dsb92/smartpram/README.txt

SmartPram - Den intelligente barnevogn
- 3. semesterprojekt

Projektbeskrivelse: Systemet eksisterer for, at kunne få en baby til at falde i s
øvn/berolige den. Brugeren har
mulighed for at definere, hvordan systemet skal fungere via sit Devkit8000. Der kan indstilles
vuggetid, urotid og lydstyrke, som systemets automatiske funktioner reagerer på. Yderligere
kan brugeren indstille den temperatur-værdi som han/hun 
ønsker barnevognen max/min må
være. Brugeren kan tænde og slukke for den automatiske funktion eller selv kø
re en cyklus af
motorerne ved at trykke på de manuelle knapper.

Hvad jeg har arbejdet med: Linux programmering, Backend driver til Devkit8000, håndtering af beskeder og flertrådet system.
