dsb92/smartpram/Hardware/Komponentliste.pdf

## PSoC kredsløb

Komponentnavn | Type | Størelse
X101 | Sikring | 1,6 A
C101 | Kondensator | 10 µF
C102 | Kondensator | 100 nF
C103 | Kondensator | 100 nF
C104 | Kondensator | 100 nF
C105 | Kondensator | 1 µF
R101 | Modstand | 2,2 kΩ
R102 | Modstand | 100 kΩ
R103 | Modstand | 10 kΩ
R104 | Modstand | 10 kΩ
R105 | Modstand | 10 kΩ
R106 | Modstand | 10 kΩ
R107 | Modstand | 10 kΩ
R108 | Modstand | 10 kΩ
R109 | Modstand | 10 Ω
R110 | Modstand | 100 kΩ
R111 | Modstand | 100 kΩ
R112 | Modstand | 1 MΩ
R113 | Modstand | 100 kΩ
NTC_100K | Modstand | Variabel mellem
LM_7805 | Spændingsregulator | Regulerer fra 12V til 5V
Q101 | MOSFET Transistor | IRLZ44N
Q102 | MOSFET Transistor | IRLZ44N
U102 | 2233f024s DC motor | 308:1
U103 | IC34 DC motor | 729:1
U105 | PSoC 3 Microcontrolller
U104 | ZigBee | MRF24J40MA
Mikrofon | MCE-100 | 0,1-4,7 µF
U107 | AD620 Instrumenteringsforstærker

## DevKit Kredsløb

Komponentnavn | Type | Størelse
U201 | DevKit8000 Port J5
U202 | DevKit8000 Port J9
U203 | ZigBee | MRF24J40MA
R201 | Modstand | 10 kΩ
R202 | Modstand | 10 kΩ
R203 | Modstand | 10 kΩ
R204 | Modstand | 10 kΩ
C201 | Kondensator | 100 nF

# Komponentliste
