dsb92/smartpram/Software/DevKit8000/Design/Klassediagram_Devkit.pdf

Class Application model

UIController

+ enum { ID_CRADLE_STOPPED, ID_MOBILE_STOPPED, ID_SETTINGS_CFM, ID_MEASUREMENTS }
- MAX_QUEUE_SIZE: static const int
- manualMq_: osapi::MsgQueue*
- settingsCtrlMq_: osapi::MsgQueue*
- automaticMq_: osapi::MsgQueue*
- mq_: osapi::MsgQueue
- running_: bool
+ cradleOnManUIbutton_: bool
+ mobileOnManUIbutton_: bool
- minTemp_: bool
- maxTemp_: bool
- soundHigh_ : bool
+ minTemperatur_: signed char + maxTemperatur_: signed char + maxSound_: signed char
+ temperatur_ : signed char
+ sound_: signed char
+ cradleTime_: unsigned int + mobileTime_: unsigned int

+ setMqs(manualMq: osapi::MsgQueue*, osapi::MsgQueue automaticMq_, settingsCtrlMq: osapi::MsgQueue): void
+ startCradle() : void
+ stopCradle() : void
+ startMobile() : void
+ stopMobile() : void
+ startAutomatic() : void
+ stopAutomatic() : void
+ getCurrentSettings() : void
+ setSaveSettings(_cradleTime: unsigned int, _cradleSpeed: unsigned char, _mobileTime: unsigned int, _mobileSpeed: unsigned char, _minTemperatur: signed char, _maxTemperatur: signed char, _maxSound: signed char )
+ setDefaultSettings(): void
+ getMsgQueue(): osapi::MsgQueue* : void
- void handleMsg(msg :osapi::Message*, id: unsigned long) : void # run(): void

osapi::Message

osapi:Thread

«utility»
main
- objUIController: UIController
- objManuelController: ManuelController
- objAutomaticController: AutomaticController
- objMeasurementsController: MeasurementsController
- objSettings: Settings
- objCradle: Cradle
- objMobile: Mobile
- objZigBeeIF_out: ZigBeeIF_out
- objZigBeeIF_in: ZigBeeIF_in
- thrUIController: osapi::Thread
- thrManuelController: osapi::Thread
- thrAutomaticController: osapi::Thread
- thrMeasurementsController: osapi::Thread
- thrCradle: osapi::Thread
- thrMobile: osapi::Thread
- thrZigBeeIF_in: osapi::Thread
- thrZigBeeIF_out: osapi::Thread

1

8

Settings

- cradleTime_: unsigned int
- mobileTime_: unsigned int
- cradleSpeed_: unsigned char
- mobileSpeed_: unsigned char
- minTemperature_: signed char
- maxTemperature_: signed char
- maxSound_: signed char

+ setCradleTime(unsigned int) : void
+ setMobileTime(unsigned int) : void
+ setCradleSpeed(unsigned char) : void + setMobileSpeed(unsigned char) : void + setTempMax(signed char) : void
+ setTempMin(signed char) : void
+ setMaxSound(signed char) : void
+ getCradleTime() : unsigned int
+ getMobileTime() : unsigned int
+ getCradleSpeed() : unsigned char + getMobileSpeed() : unsigned char + getMaxTemperatur() : signed char + getMinTemperatur() : signed char + getMaxSound() : signed char

SettingsController

+ enum { ID_SAVE_SETTINGS, ID_SETTINGS_REQ, ID_DEFAULT_SETTINGS }
- MAX_QUEUE_SIZE: static const int
- UIMq_: osapi::MsgQueue*
- mq_: osapi::MsgQueue
- cradleMq_: osapi::MsgQueue
- mobileMq_: osapi::MsgQueue
- UIMq_: osapi::MsgQueue
- measurementsMq_: osapi::MsgQueue
- running_: bool
- settingsPtr_: Settings*

+ getMsgQueue(): osapi::MsgQueue*
- void handleMsg(msg :osapi::Message*, id: unsigned long): void
# run(): void

+ setMqs( osapi::MsgQueue* UIMq, osapi::MsgQueue* cradleMq, osapi::MsgQueue* mobileMq, osapi::MsgQueue* measurementsMq ): void
+ init() : void
+ saveSettings() : void
+ loadSettings() : void
+ loadDefaultSettings() : void + broadcastSettings() : void

MsgSettings

- cradleTime: unsigned int
- mobileTime: unsigned int
- cradleSpeed: unsigned char
- mobileSpeed: unsigned char
- minTemperature: signed char
- maxTemperature: signed char
- maxSound: signed char

MsgStandard

ZigBeeIF_out

+ enum { ID_CRADLE_START, ID_CRADLE_STOP, ID_MOBILE_START, ID_MOBILE_STOP, ID_TIME_OUT }
- MAX_QUEUE_SIZE: static const int
- BUFFERSIZE_OUT: static const int
- CRADLE_OUT_POSITION : static const int
- MOBILE_OUT_POSITION : static const int
- SENDFREQ_SEC : static const unsigned long
- mq_: osapi::MsgQueue
- running_: bool
- sendOn_ : bool
- bufferOut_[BUFFERSIZE_OUT]: unsigned char
- timer_: osapi::ITimerId*

+ getMsgQueue(): osapi::MsgQueue*
+ setCradleSpeed(cradleSpeed: unsigned char) : void + setMobileSpeed(mobileSpeed: unsigned char) : void + sendData() : void
+ startSend() : void
+ stopSend() : void
- void handleMsg(msg :osapi::Message*, id: unsigned long): void # run(): void

ManualController

+ enum { ID_START_CRADLE, ID_STOP_CRADLE, ID_CRADLE_STOPPED, ID_START_MOBILE, ID_STOP_MOBILE, ID_MOBILE_STOPPED }
+ MAX_QUEUE_SIZE: static const int
- UIMq_: osapi::MsgQueue*
- cradleMq_: osapi::MsgQueue*
- mobileMq_: osapi::MsgQueue*
- mq_: osapi::MsgQueue
- running_: bool

+ getMsgQueue(): osapi::MsgQueue*
- void handleMsg(msg :osapi::Message*, id: unsigned long) : void
# run(): void

+ setMqs(cradleMq: osapi::MsgQueue*, mobileMq: osapi::MsgQueue* UIMq: osapi::MsgQueue*): void

Cradle

+ enum { ID_START_CRADLE_MANUAL, ID_START_CRADLE_AUTOMATIC ID_STOP_CRADLE, ID_STOP_CRADLE_ ID_TIME_OUT, ID_UPDATE_SETTING }
- MAX_QUEUE_SIZE: static const int
- zigbeeOutMq_: osapi::MsgQueue*
- manualMq_: osapi::MsgQueue*
- automaticMq_: osapi::MsgQueue*
- mq_: osapi::MsgQueue
- running_: bool
- cradleOn_: bool
- manuelControl_: bool
- automaticControl_: bool
- cradleTime_: unsigned int
- cradleSpeed_: unsigned char
- timer_: osapi::ITimerId*

+ getMsgQueue(): osapi::MsgQueue*
- void handleMsg(msg :osapi::Message*, id: unsigned long): void
# run(): void

+ setMqs(manualMq: osapi::MsgQueue*, automaticMq: osapi::MsgQueue*, zigbeeOutMq: osapi::MsgQueue*): void

Mobile

+ enum { ID_START_MOBILE_AUTOMATIC, ID_STOP_MOBILE_MANUEL, ID_STOP_MOBILE, ID_UPDATE_SETTING, ID_TIME_OUT }
- MAX_QUEUE_SIZE: static const int
- zigbeeOutMq_: osapi::MsgQueue*
- manualMq_: osapi::MsgQueue*
- automaticMq_: osapi::MsgQueue*
- mq_: osapi::MsgQueue
- running_: bool
- mobileOn_: bool
- manualControl_: bool
- automaticControl_: bool
- mobileTime_: unsigned int
- mobileSpeed_: unsigned char
- timer_; osapi::ITimerId*

+ getMsgQueue(): osapi::MsgQueue*
- void handleMsg(msg :osapi::Message*, id: unsigned long): void
# run(): void

+ setMqs(manualMq: osapi::MsgQueue*, automaticMq: osapi::MsgQueue*, zigbeeOutMq: osapi::MsgQueue*): void

MsgSendSetting

time : unsigned int
speed: unsigned char

osapi::ThreadFunctor

MsgSendMeasurementsSetting

minTemperature: signed char maxTemperature: signed char maxSound: signed char

MsgMeasurements

temperature: signed char
sound: signed char

MsgAnalysedMeasurements

temperature: signed char
sound: signed char
temperatureLow: bool
temperatureHigh: bool
soundHigh: bool

MeasurementsController

+ enum { ID_UPDATE_SETTING, ID_UPDATE_MEASUREMENTS, ID_CHECK_SOUND, ID_CHECK_SOUND_AGAIN, ID_TIMEOUT_CRADLE, ID_TIMEOUT_MOBILE, ID_AUTOMATIC_STOPPED }
- MAX_QUEUE_SIZE: static const int
- TIMERWAIT: static const int
- ZigBeeOutMq__: osapi::MsgQueue*
- UIMq_: osapi::MsgQueue*
- automaticMq_: osapi::MsgQueue*
- mq_: osapi::MsgQueue
- running_: bool
- checkSound_: bool
- minTemperatur_: signed char
- maxTemperatur_: signed char
- maxSound_: signed char
- temperatur_: signed char
- sound_: signed char
- temperaturLow_: bool
- temperaturHigh_: bool
- soundHigh_: bool
- averageSoundCheck_[AVERAGESOUNDCHECK_SIZE]: bool
- AVERAGESOUNDCHECK_SIZE: static const unsigned int
- AVERAGESOUNDCHECK_TRUECHECK: static const unsigned int
- timerCradle_: osapi::ITimerId*
- timerMobile_: osapi::ITimerId*

+ getMsgQueue(): osapi::MsgQueue*
- void handleMsg(msg :osapi::Message*, id: unsigned long): void
# run(): void

+setMqs( osapi::MsgQueue* UIMq, osapi::MsgQueue* automaticMq ) : void + analyse() : void
+ setAverageSoundCheck() : void
+ getAverageSoundCheck() : void

ZigBeeIF_in

- BUFFERSIZE_IN : static const int
- TEMPERATURE_IN_POSITION : static const int
- SOUND_IN_POSITION : static const int
- measurementsMq_: osapi::MsgQueue
- running_: bool
- bufferIn_[BUFFERSIZE_IN] : signed char

# run(): void

+ receiveData() : void
+ getTemperature() : signed char
+ getSound() : signed char
+ setTest(sound: signed char, temperatur: signed char) : void + getDatapackage : void
+ setMqs(measurementsMq: osapi:: MsgQueue*) : void

AutomaticController

+ enum { ID_CHECK_SOUND, ID_START_CRADLE, ID_CHECK_SOUND_AGAIN, ID_START_MOBILE, ID_STOP_AUTOMATIC, ID_CRADLE_STOPPED, ID_MOBILE_STOPPED } + MAX_QUEUE_SIZE: static const int
- UIMq_: osapi::MsgQueue*
- cradleMq_: osapi::MsgQueue*
- mobileMq_: osapi::MsgQueue*
- meaCtrlMq_: osapi::MsgQueue*
- UIMq_: osapi::MsgQueue*
- mq_: osapi::MsgQueue
- running_: bool
- stopAutomatic: bool

+ getMsgQueue(): osapi::MsgQueue*
- void handleMsg(msg :osapi::Message*, id: unsigned long) : void
# run(): void

+ setMqs(cradleMq: osapi::MsgQueue*, mobileMq: osapi::MsgQueue*, UIMq: osapi::MsgQueue*, meaCtrlMq: osapi::MsgQueue*)

<<uses>>

<<uses>>

<<uses>>

<<uses>>

<<uses>>

<<uses>>

<<uses>>

<<uses>>

osapi::Message

<<uses>>

<<uses>>

<<uses>>

<<uses>>

<<uses>>

<<uses>>

<<uses>>

<<uses>>

MsgSendSetting

time : unsigned int
speed: unsigned char

osapi::Message

osapi::Message

<<uses>>

osapi::ThreadFunctor

osapi::ThreadFunctor

osapi::ThreadFunctor
