dsb92/smartpram/Mødereferater og tidsplan/Mødereferat D. 17-09-2013.pdf

Møde referat d. 17-09‐2013 08:15-10:00
Tilstede:
Mads, Joachim, Kristian, Anders, Sander, Kjeld & David Udeblivelse:
Jonas
Dagsorden:
1. Tilstedeværende fik SVN op og kører
2. Tilstedeværende fik Scrum op og kører
3. Påbegyndt arbejde med kravspecifikation

Dagsorden til næste møde: ‐ Aftalt møde Torsdag D. 11‐09‐2013 kl. 12:15
1. Spørge vejleder om: Kan vi når vi nu laver et Use-case diagram vælge om det skal være Smart pram eller Smart-pram’s System.
2. Fortsætte med Kravspecfikation
