dsb92/smartpram/Hardware/schematic_Controller.pdf

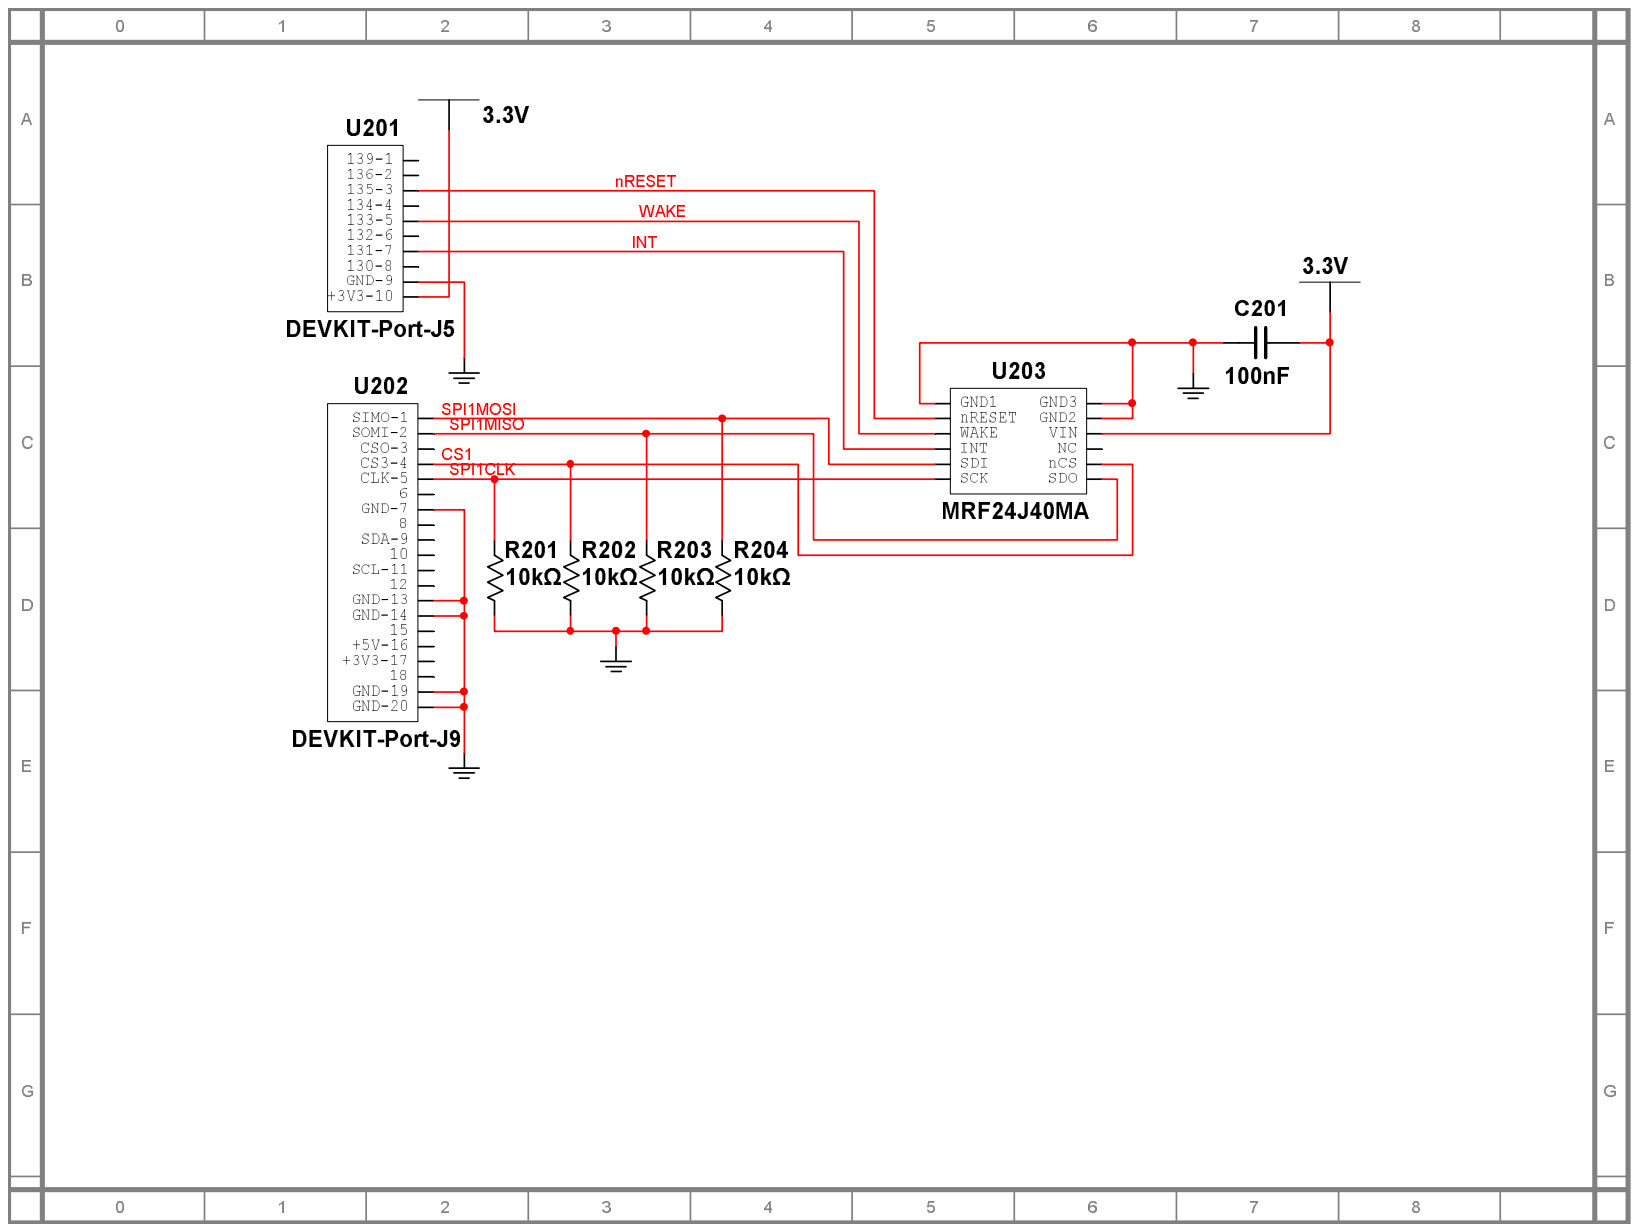
[picture p31: page 1]
