dsb92/smartpram/Hardware/schematic_Pram.pdf

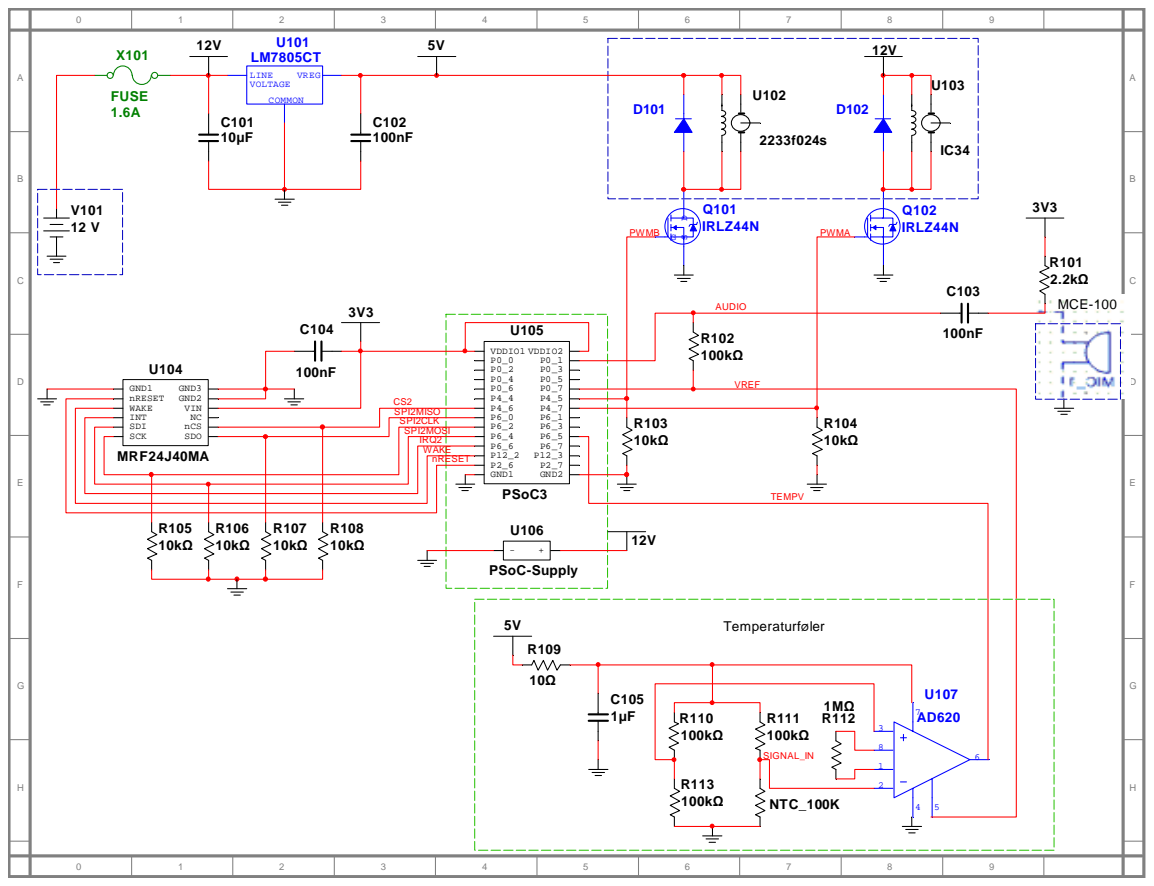
[picture p32: page 1]
