dsb92/smartpram/Datablade/Devkit8000/DevKit8000_schematic.pdf

D

6 | 5 | 4 | 3 | 2 | 1

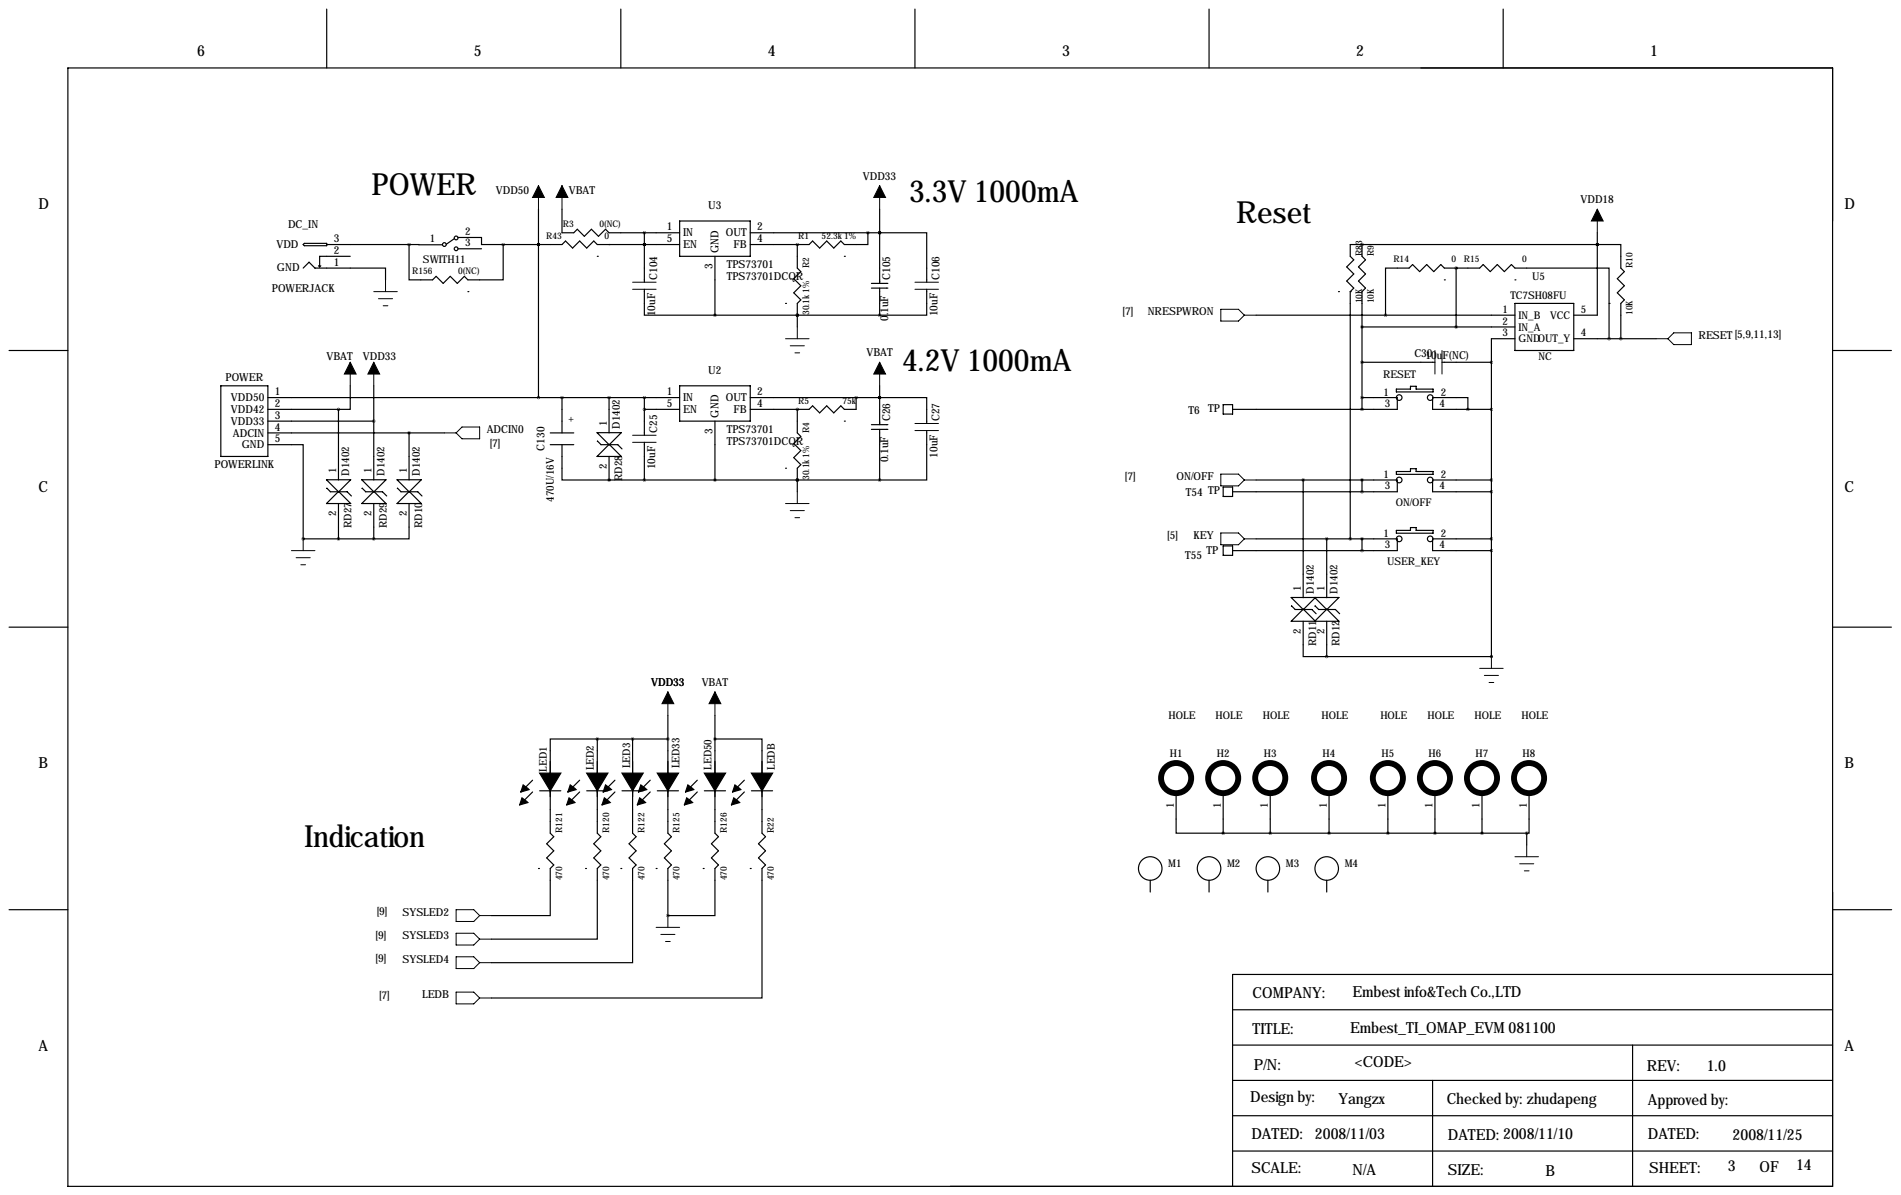
[picture p33: page 1]

Embest info&Tech Co.,LTD

P/N: <CODE> | REV: 1.0

Design by: Yangzx | Checked by: zhudapeng | Approved by:

DATED: 2008/11/03 | DATED: 2008/11/10 | DATED: 2008/11/25

SCALE: N/A | SIZE: B | SHEET: 3 OF 14

D

D

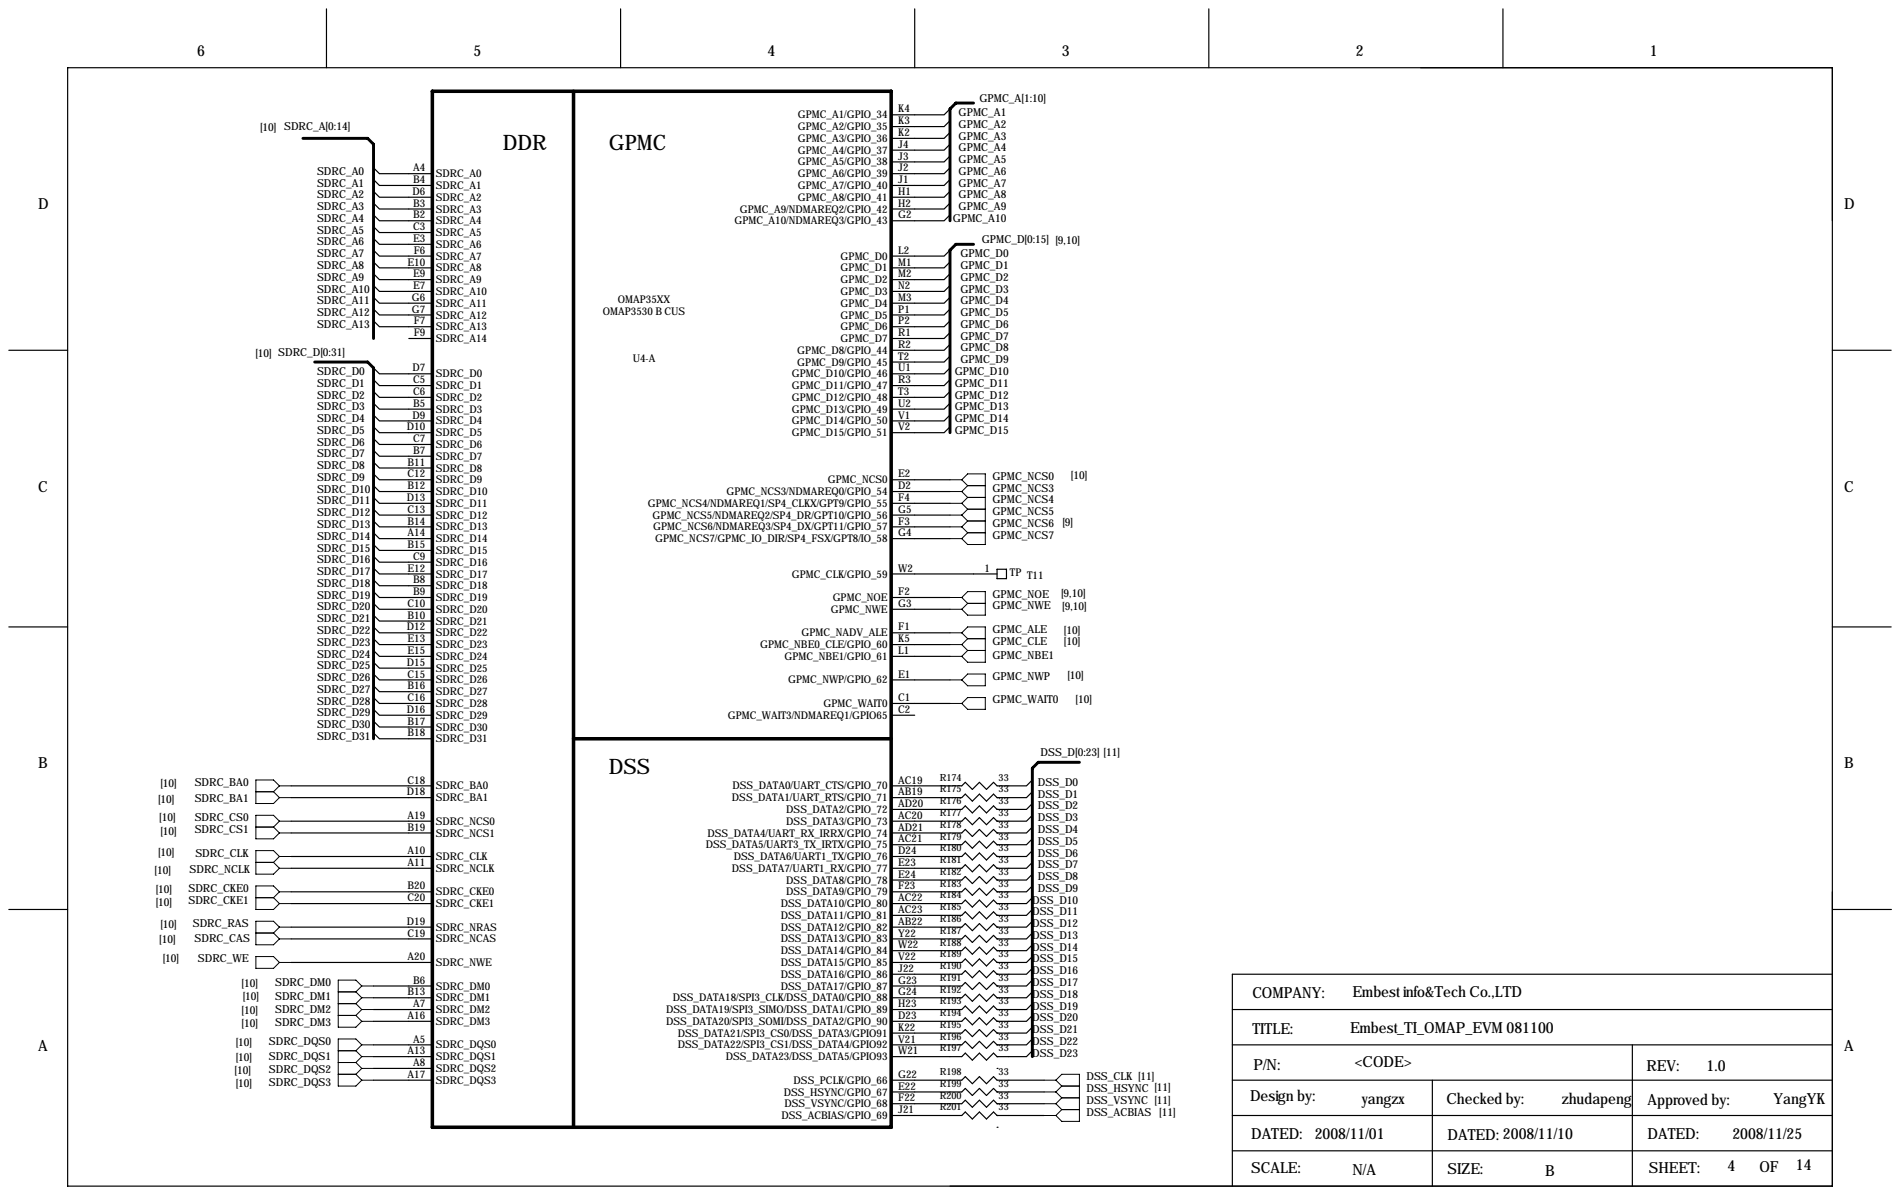
[picture p34: page 2]

Embest info&Tech Co.,LTD

DATED: 2008/11/01 | DATED: 2008/11/10 | DATED: 2008/11/25

SHEET: 4 OF 14

D

D

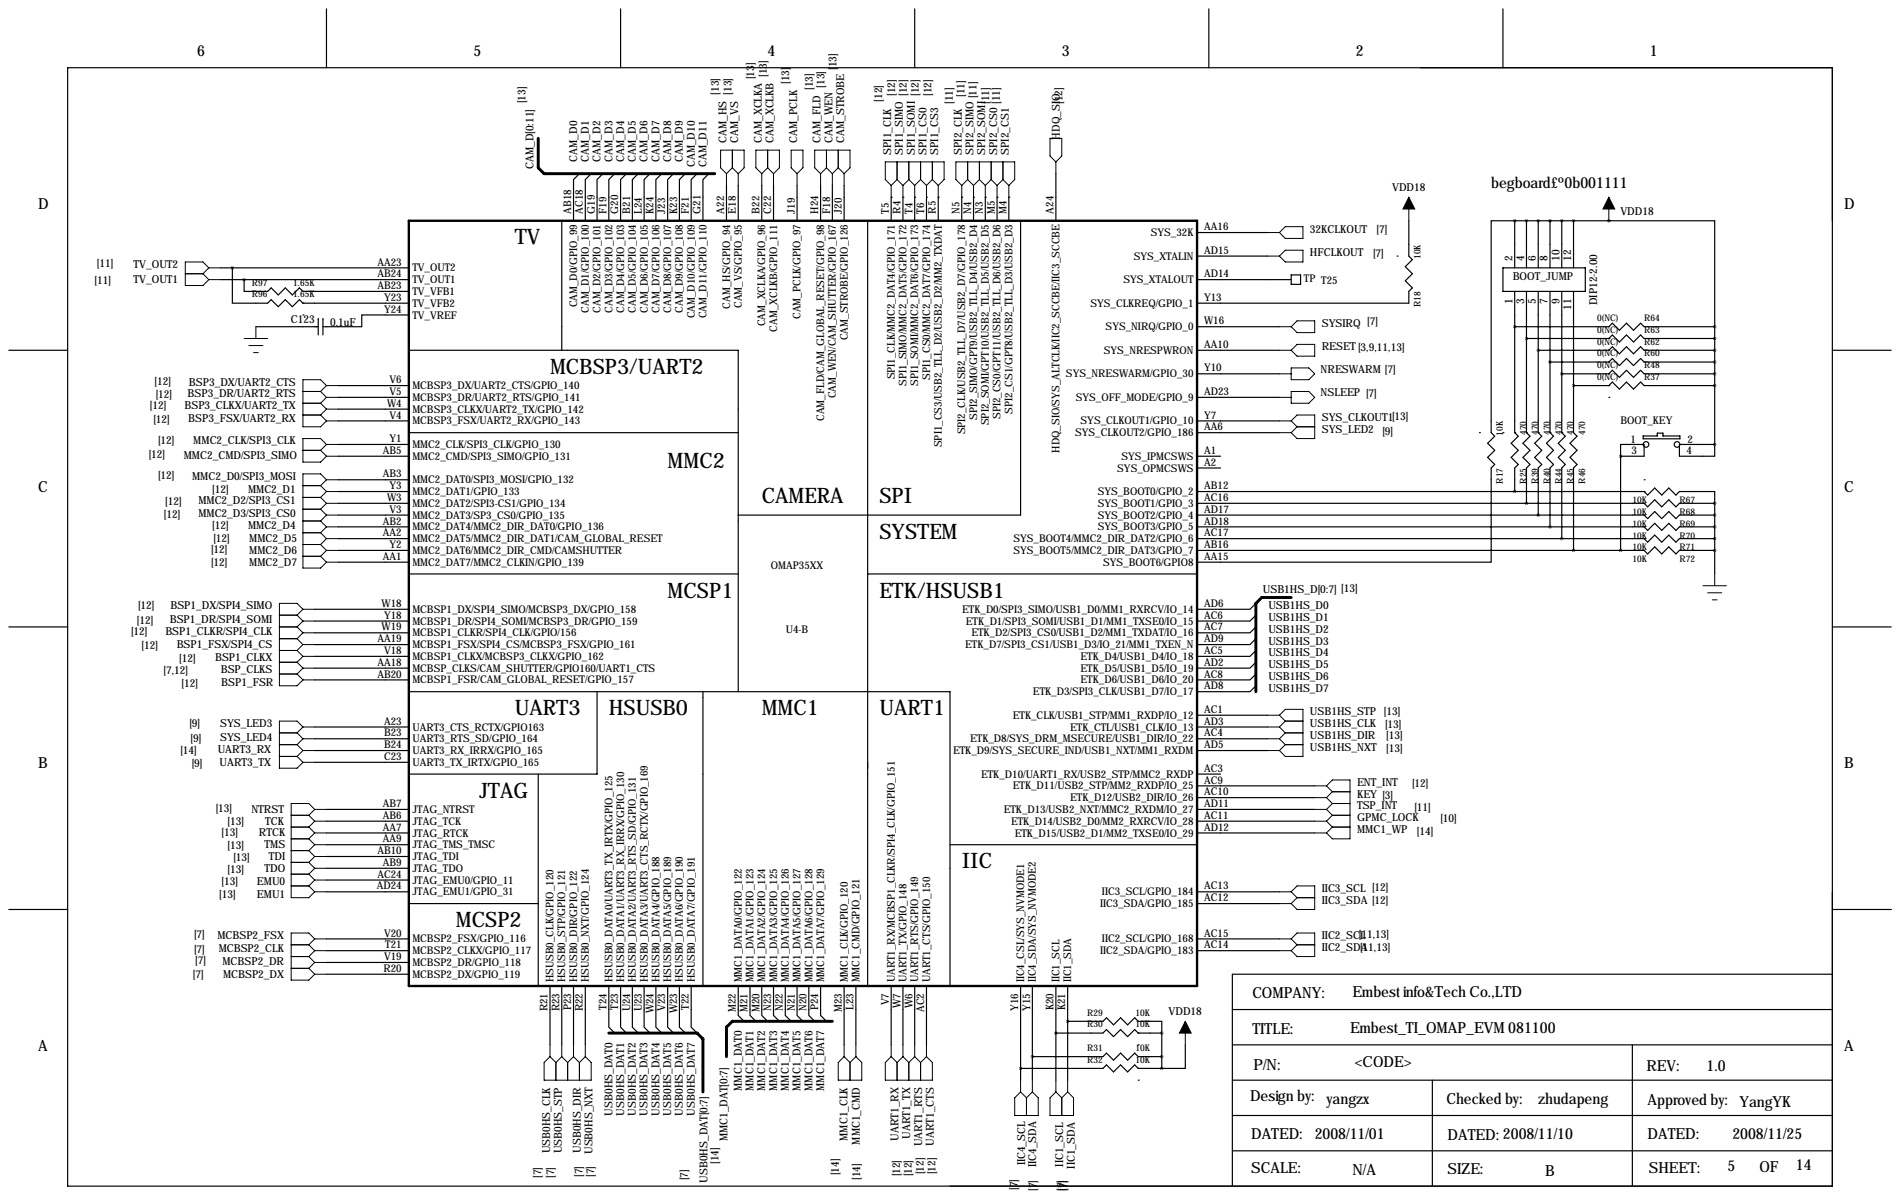
[picture p35: page 3]

Embest info&Tech Co.,LTD

P/N: <CODE> | REV: 1.0

Design by: yangzx | Checked by: zhudapeng | Approved by: YangYK

DATED: 2008/11/01 | 2008/11/10 | DATED: 2008/11/25

SHEET: 5 OF 14

## ABD

6

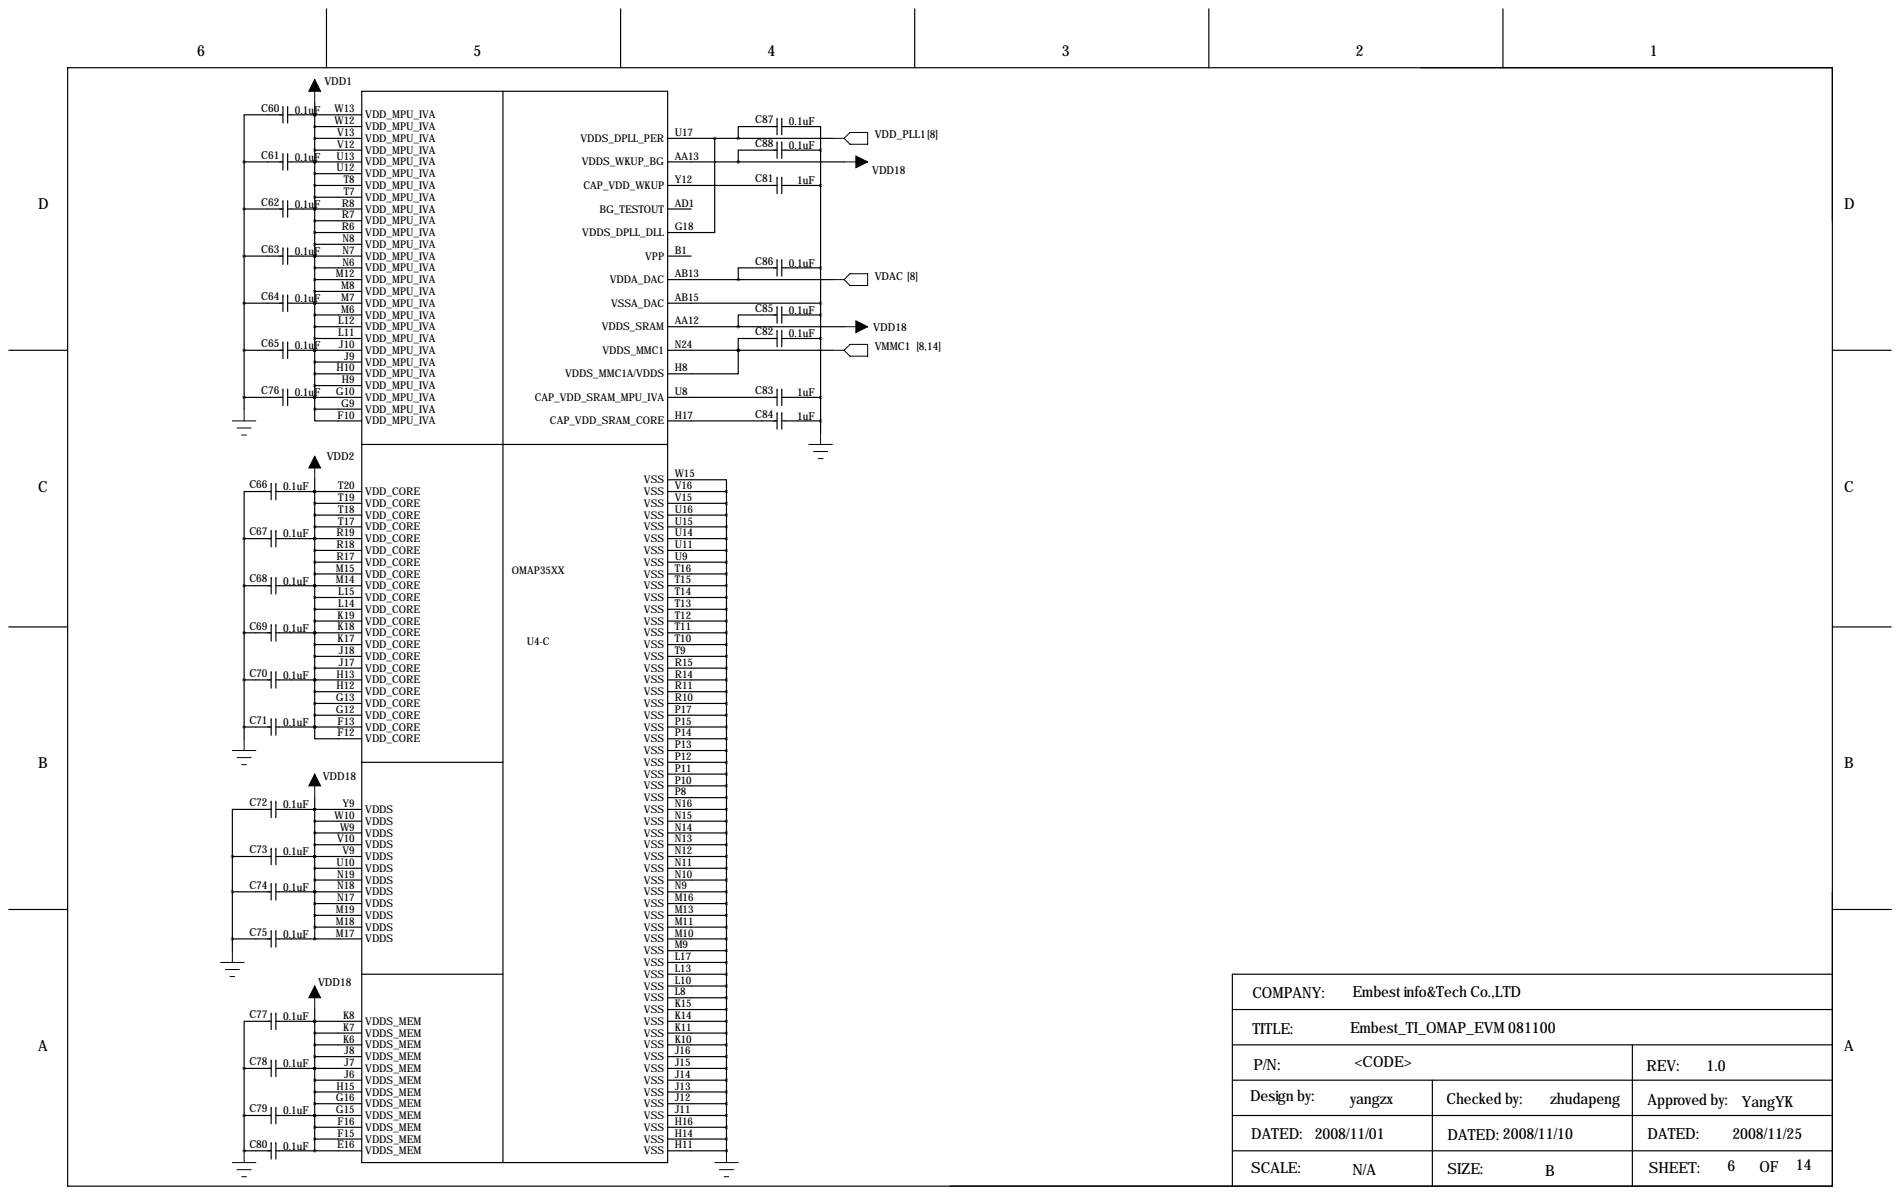
[picture p36: page 4]

Embest info&Tech Co.,LTD

P/N: <CODE> | REV: 1.0

Design by: yangzx | Checked by: zhudapeng | Approved by: YangYK

DATED: 2008/11/01 | 2008/11/10 | DATED: 2008/11/25

N/A | B | SHEET:

D

D

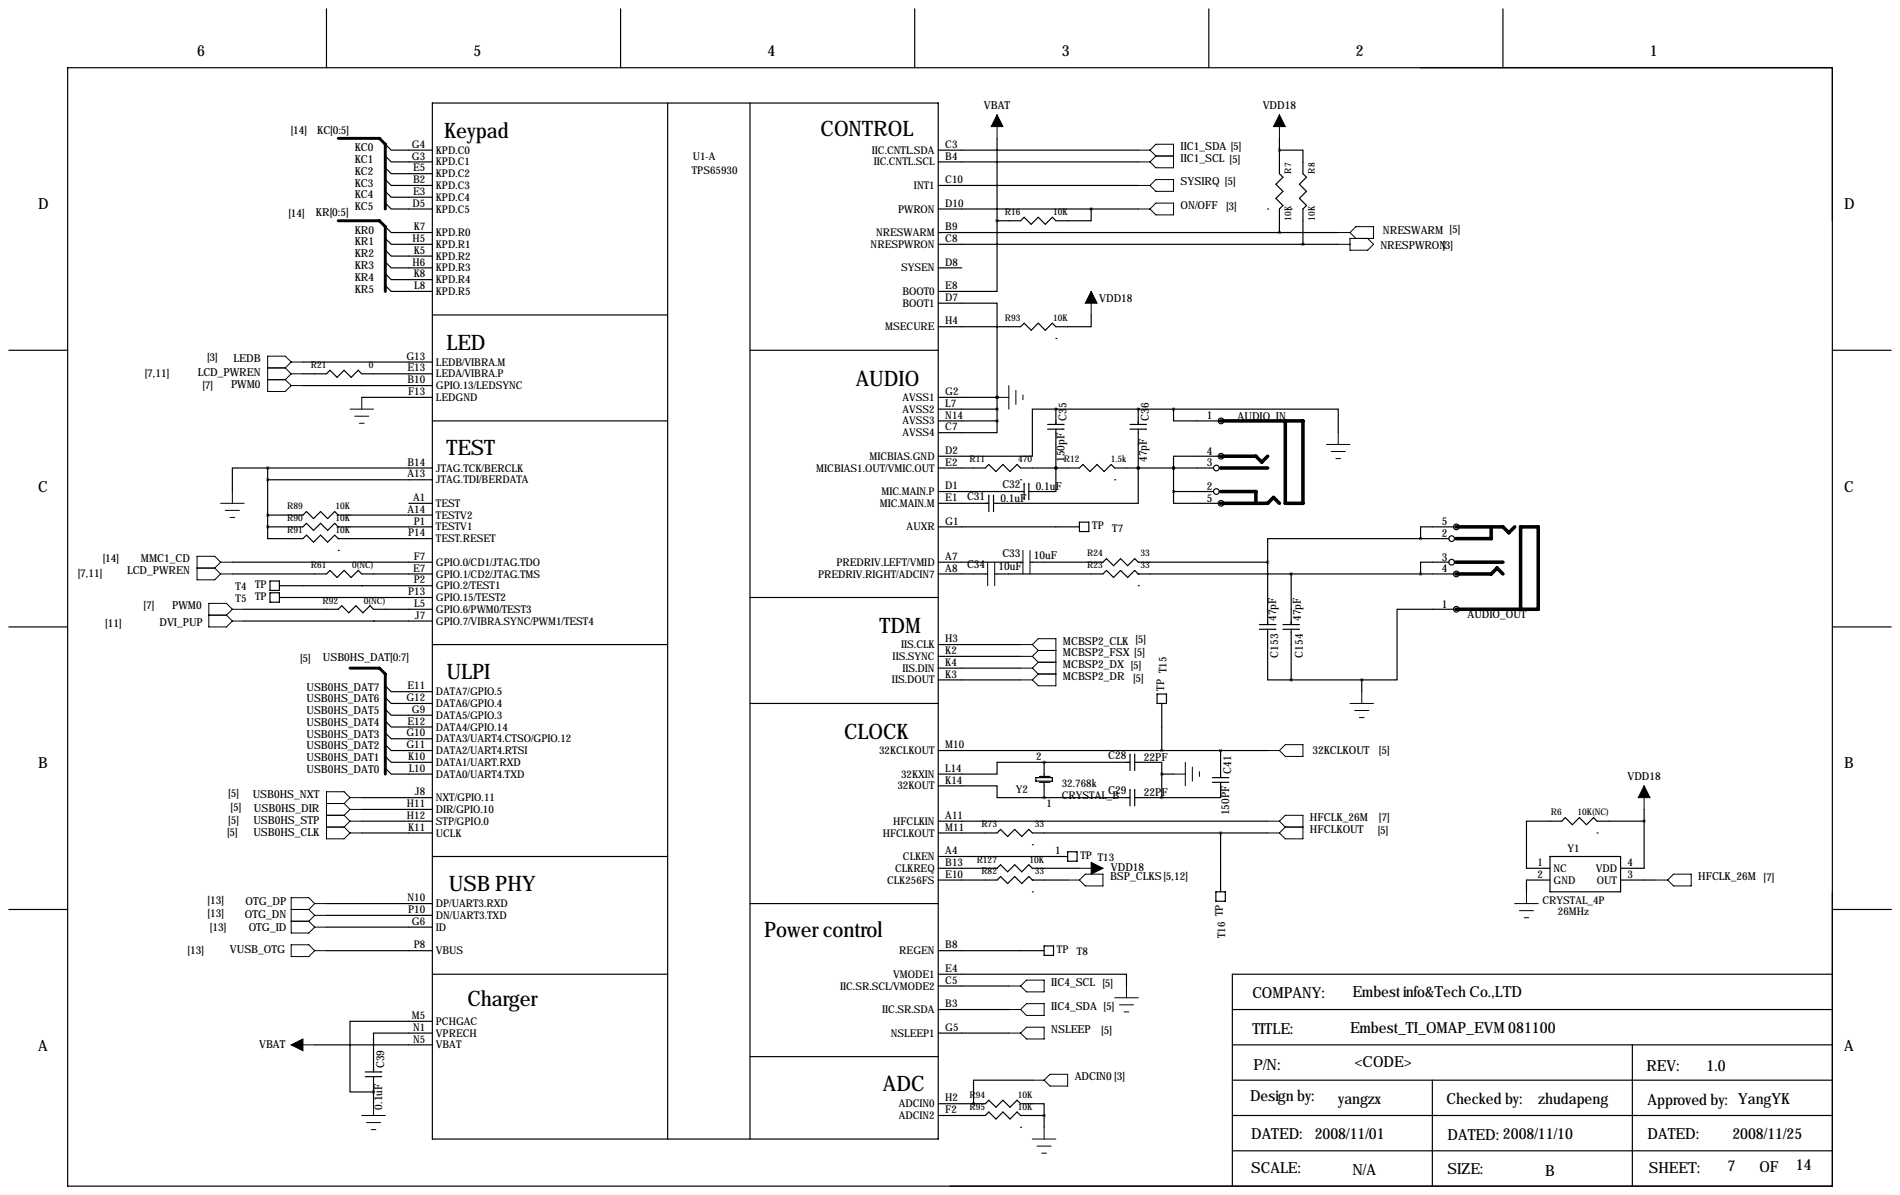
[picture p37: page 5]

Embest info&Tech Co.,LTD

P/N: <CODE> | REV: 1.0

Design by: yangzx | Checked by: zhudapeng | Approved by: YangYK

DATED: 2008/11/01 | 2008/11/10 | DATED: 2008/11/25

SHEET: 7 OF 14

D

D

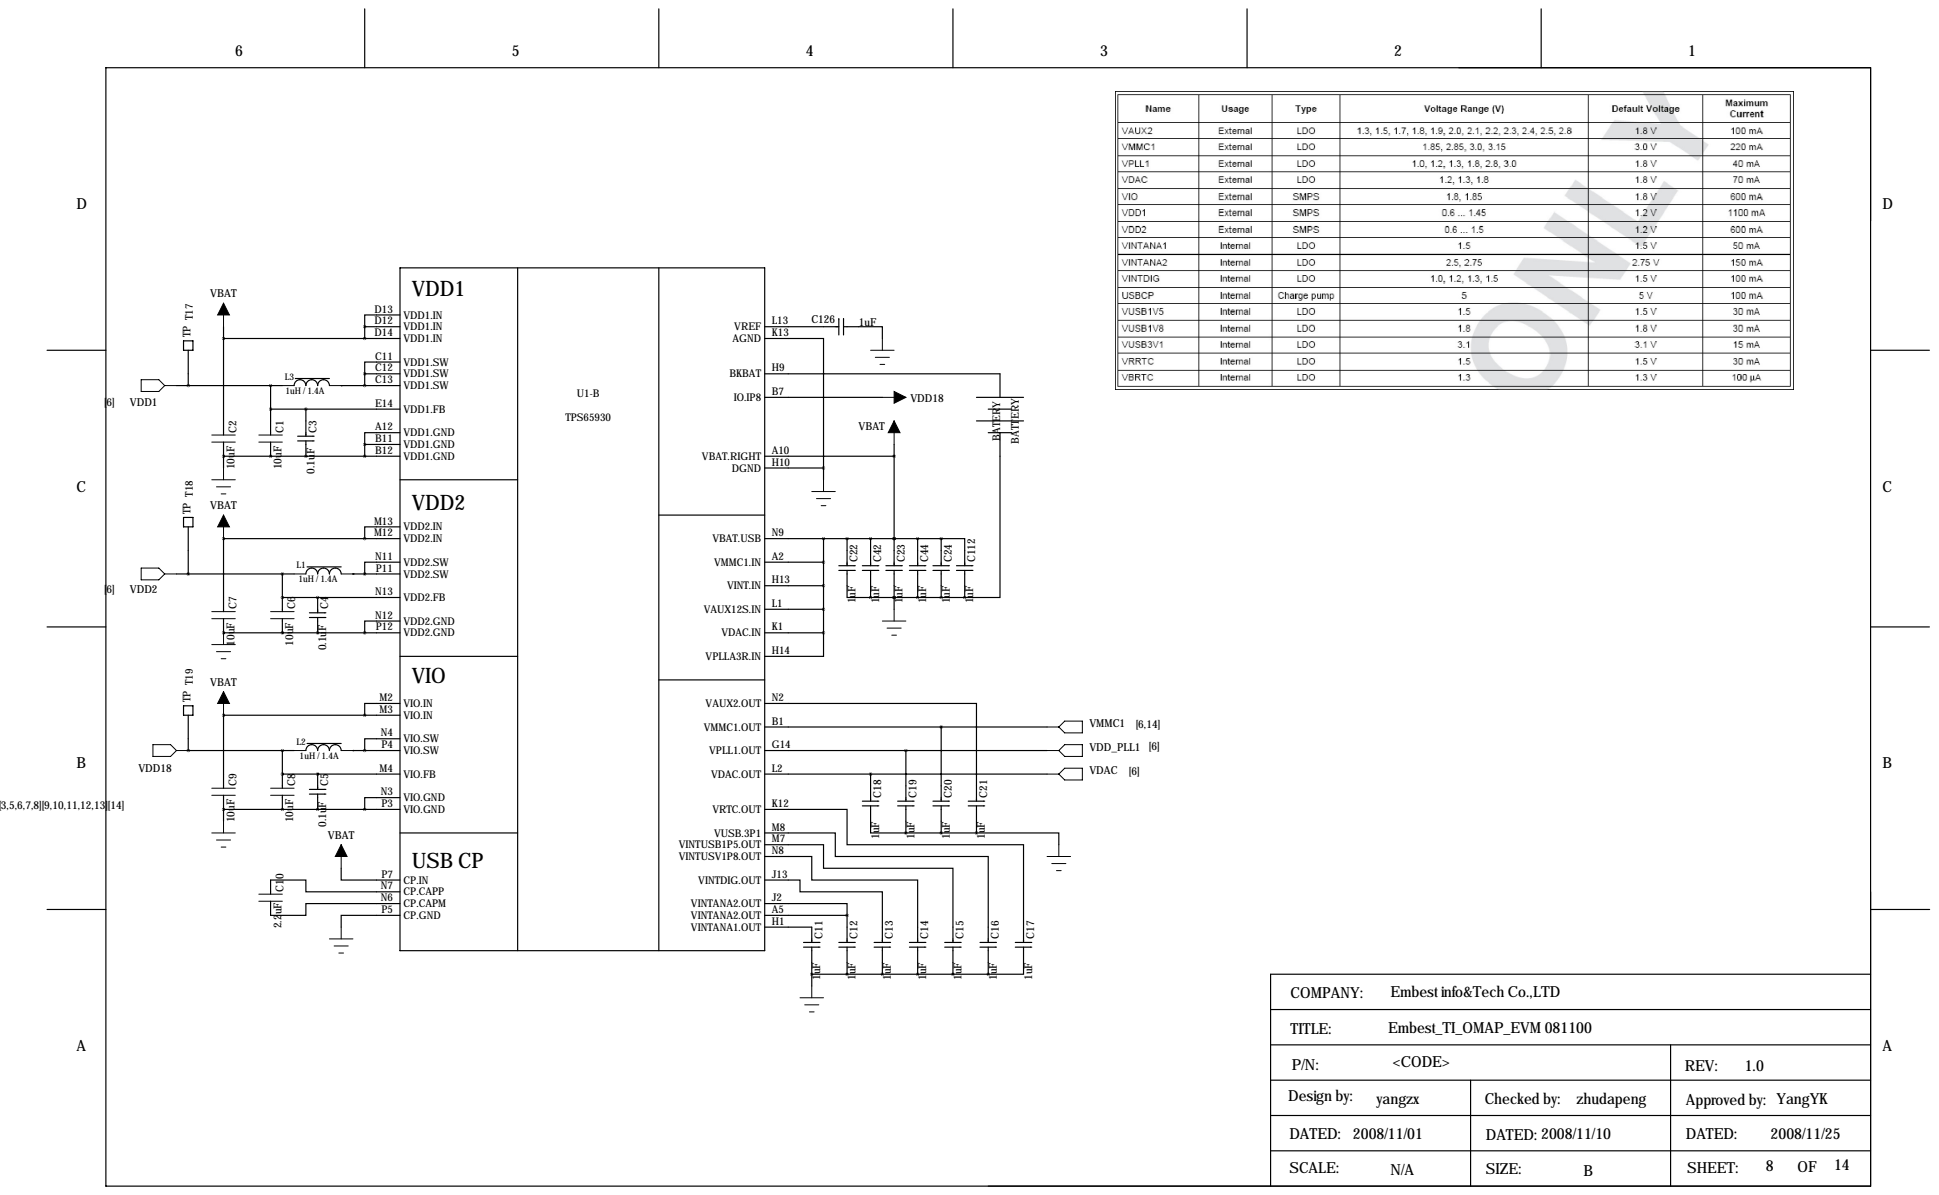
[picture p38: page 6]

A10 VBAT.RIGHT

VIO | N2 VAUX2.OUT

B1 VMMC1.OUT G14 VPLL1.OUT L2 VDAC.OUT K12 VRTC.OUT

VBAT | M8 VUSB.3P1

Embest info&Tech Co.,LTD

P/N: <CODE> | REV: 1.0

Design by: yangzx | Checked by: zhudapeng | Approved by: YangYK

DATED: 2008/11/01 | 2008/11/10 | DATED: 2008/11/25

SHEET: 8 OF 14

6

5

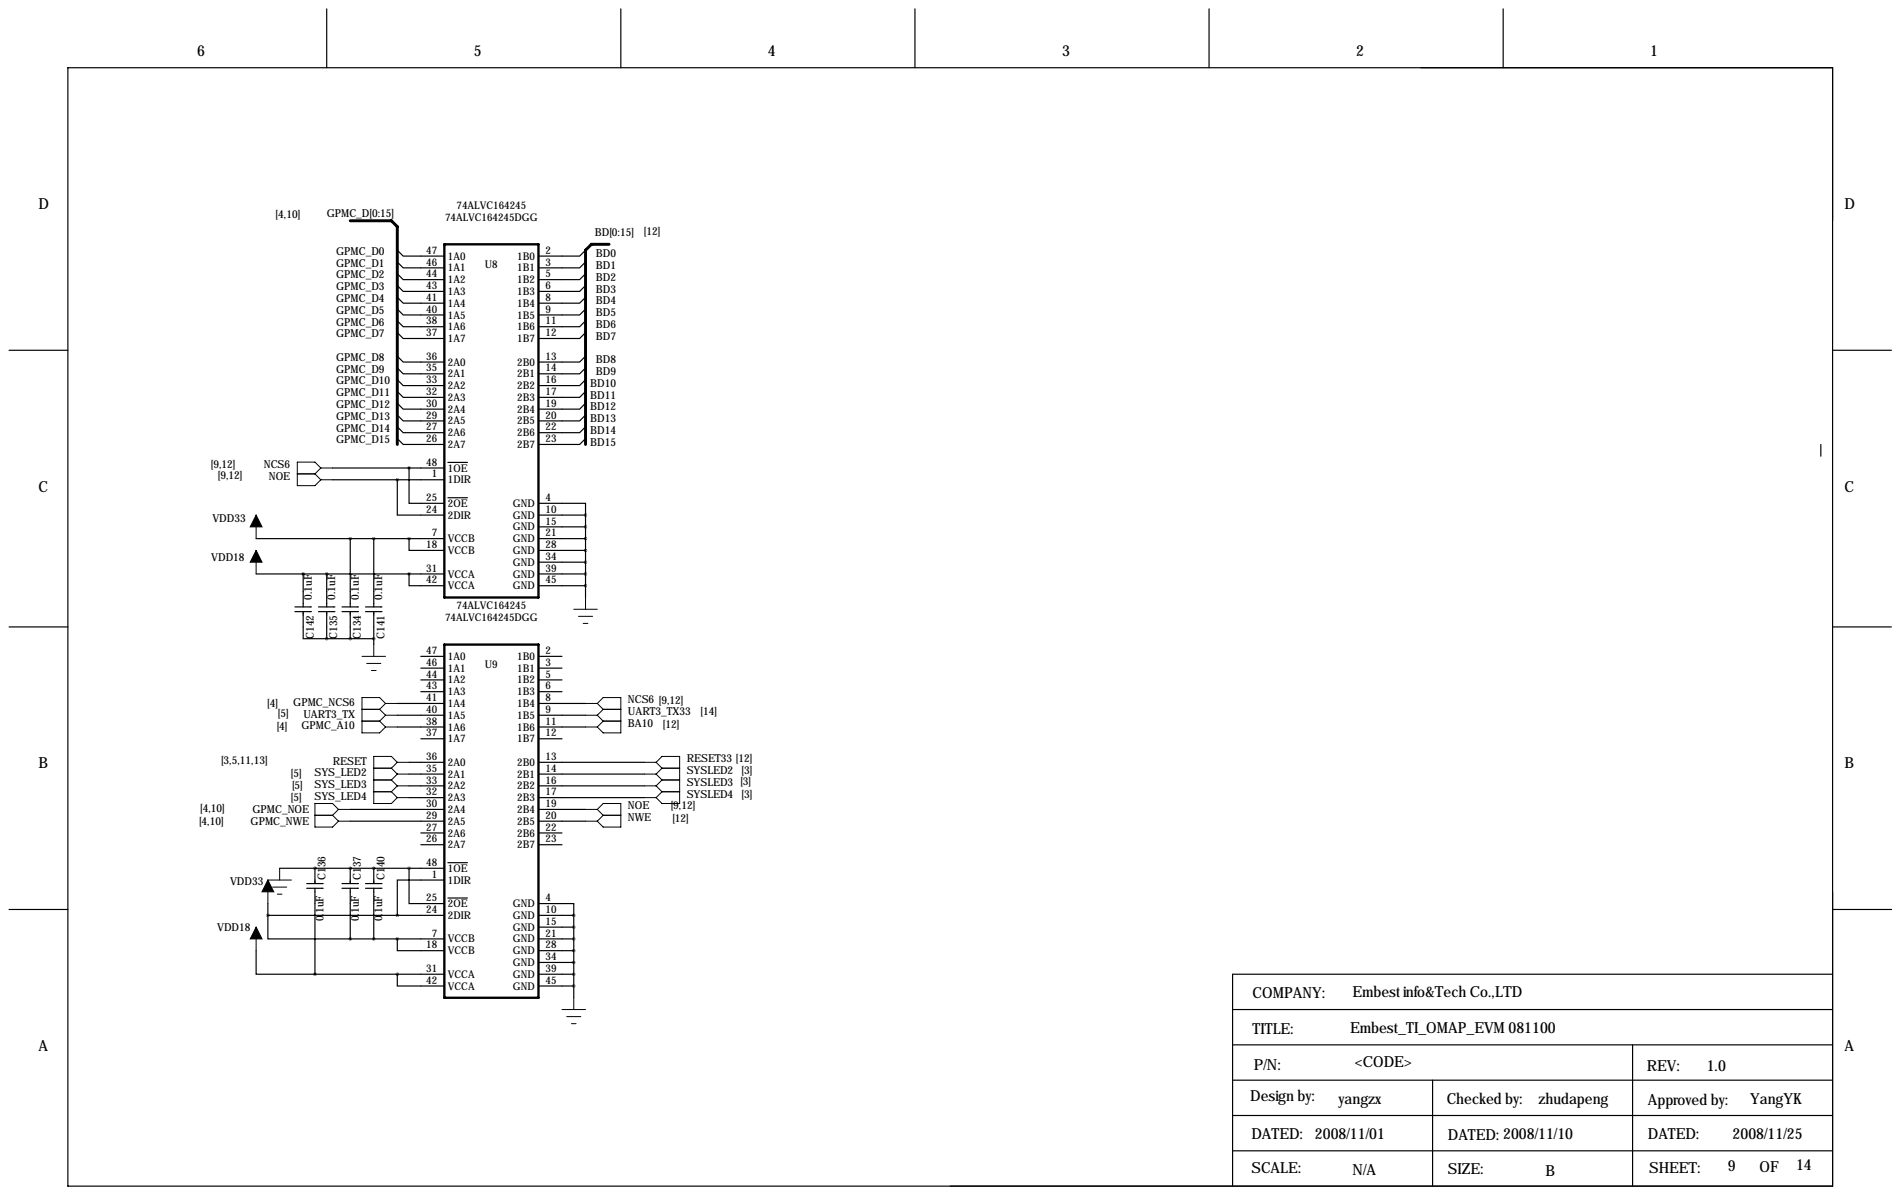
[picture p39: page 7]

Embest info&Tech Co.,LTD

P/N: <CODE> | REV: 1.0

Design by: yangzx | Checked by: zhudapeng | Approved by: YangYK

DATED: 2008/11/01 | 2008/11/10 | DATED: 2008/11/25

N/A | B | SHEET:

6

5

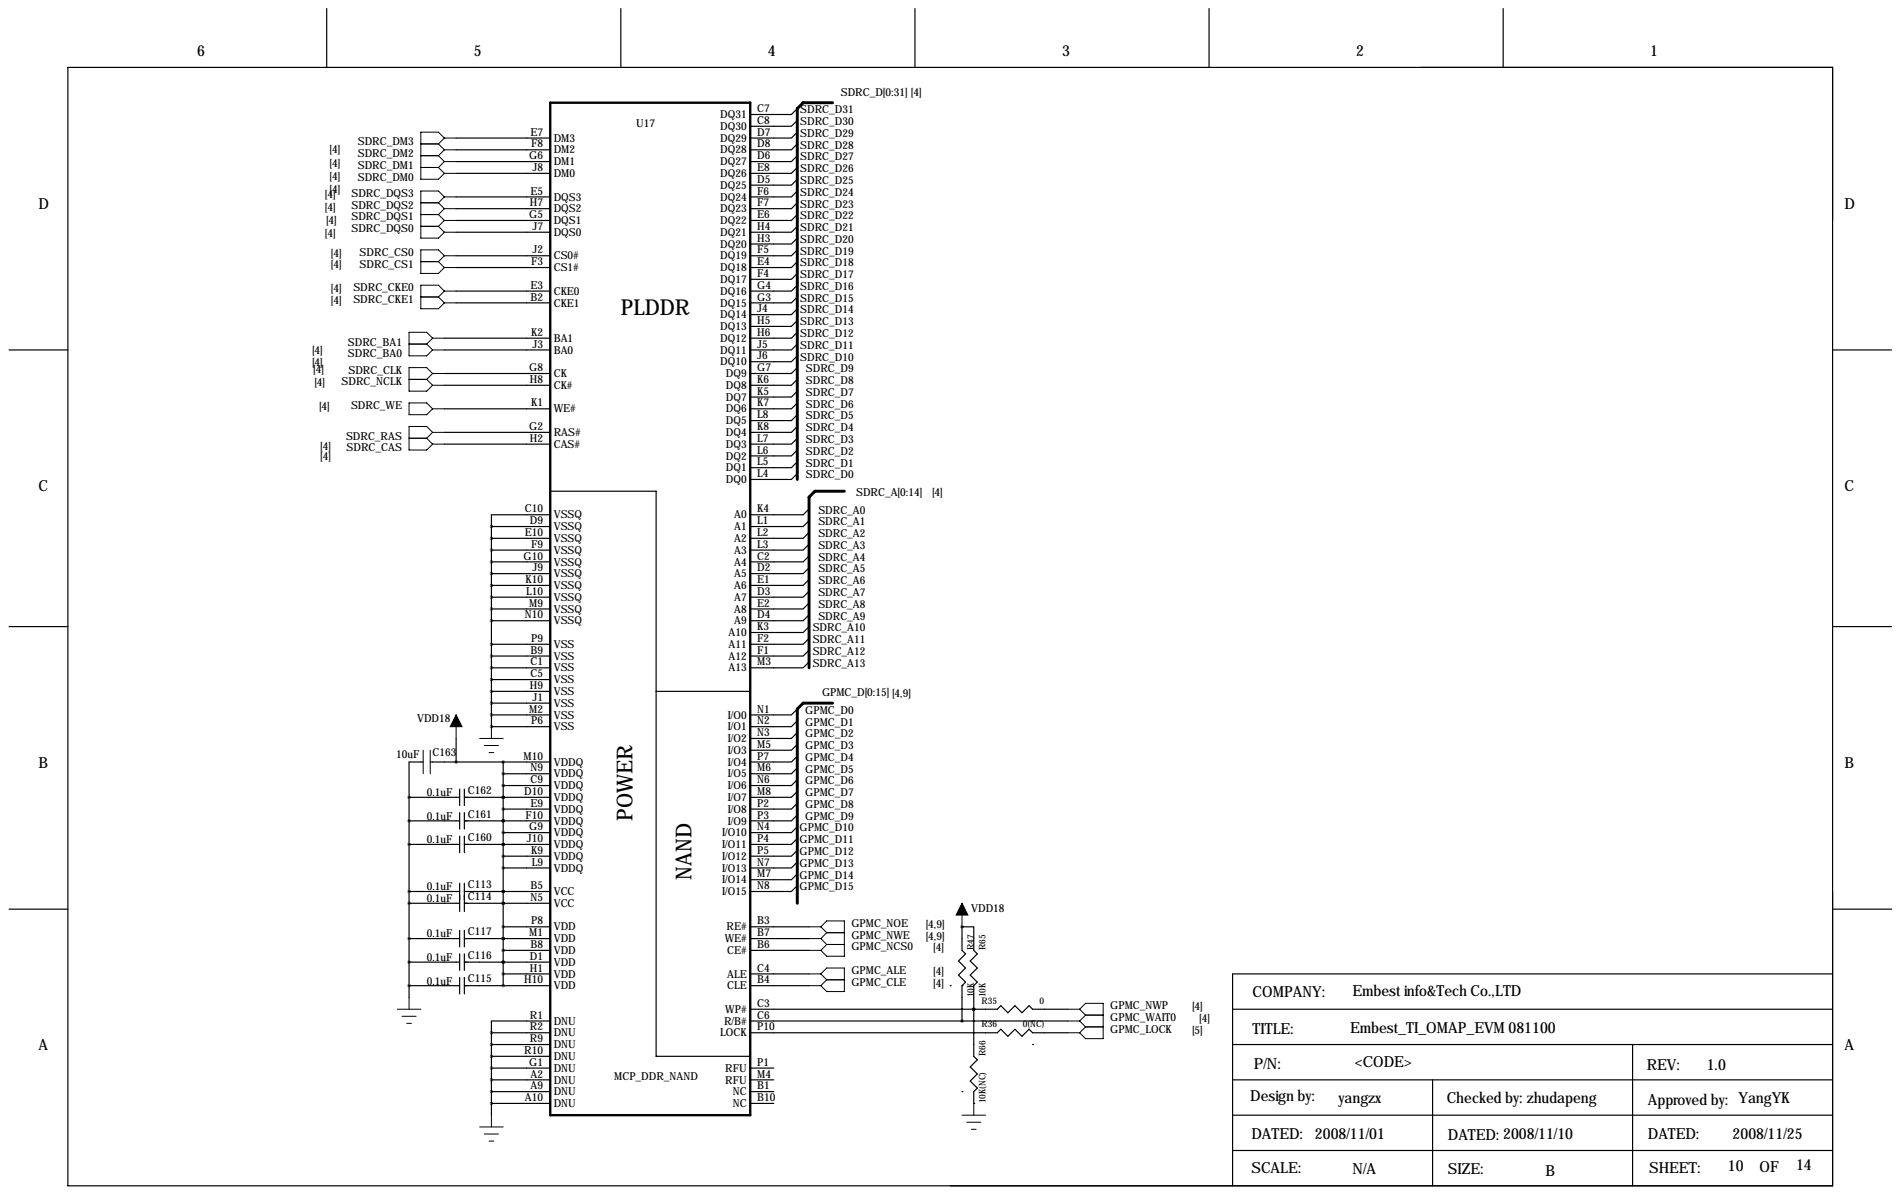
[picture p40: page 8]

Embest info&Tech Co.,LTD

P/N: <CODE> | REV: 1.0

Design by: yangzx | Checked by: zhudapeng | Approved by: YangYK

DATED: 2008/11/01 | DATED: 2008/11/10 | DATED: 2008/11/25

SCALE: N/A | SIZE: B | SHEET: 10 OF 14

D

D

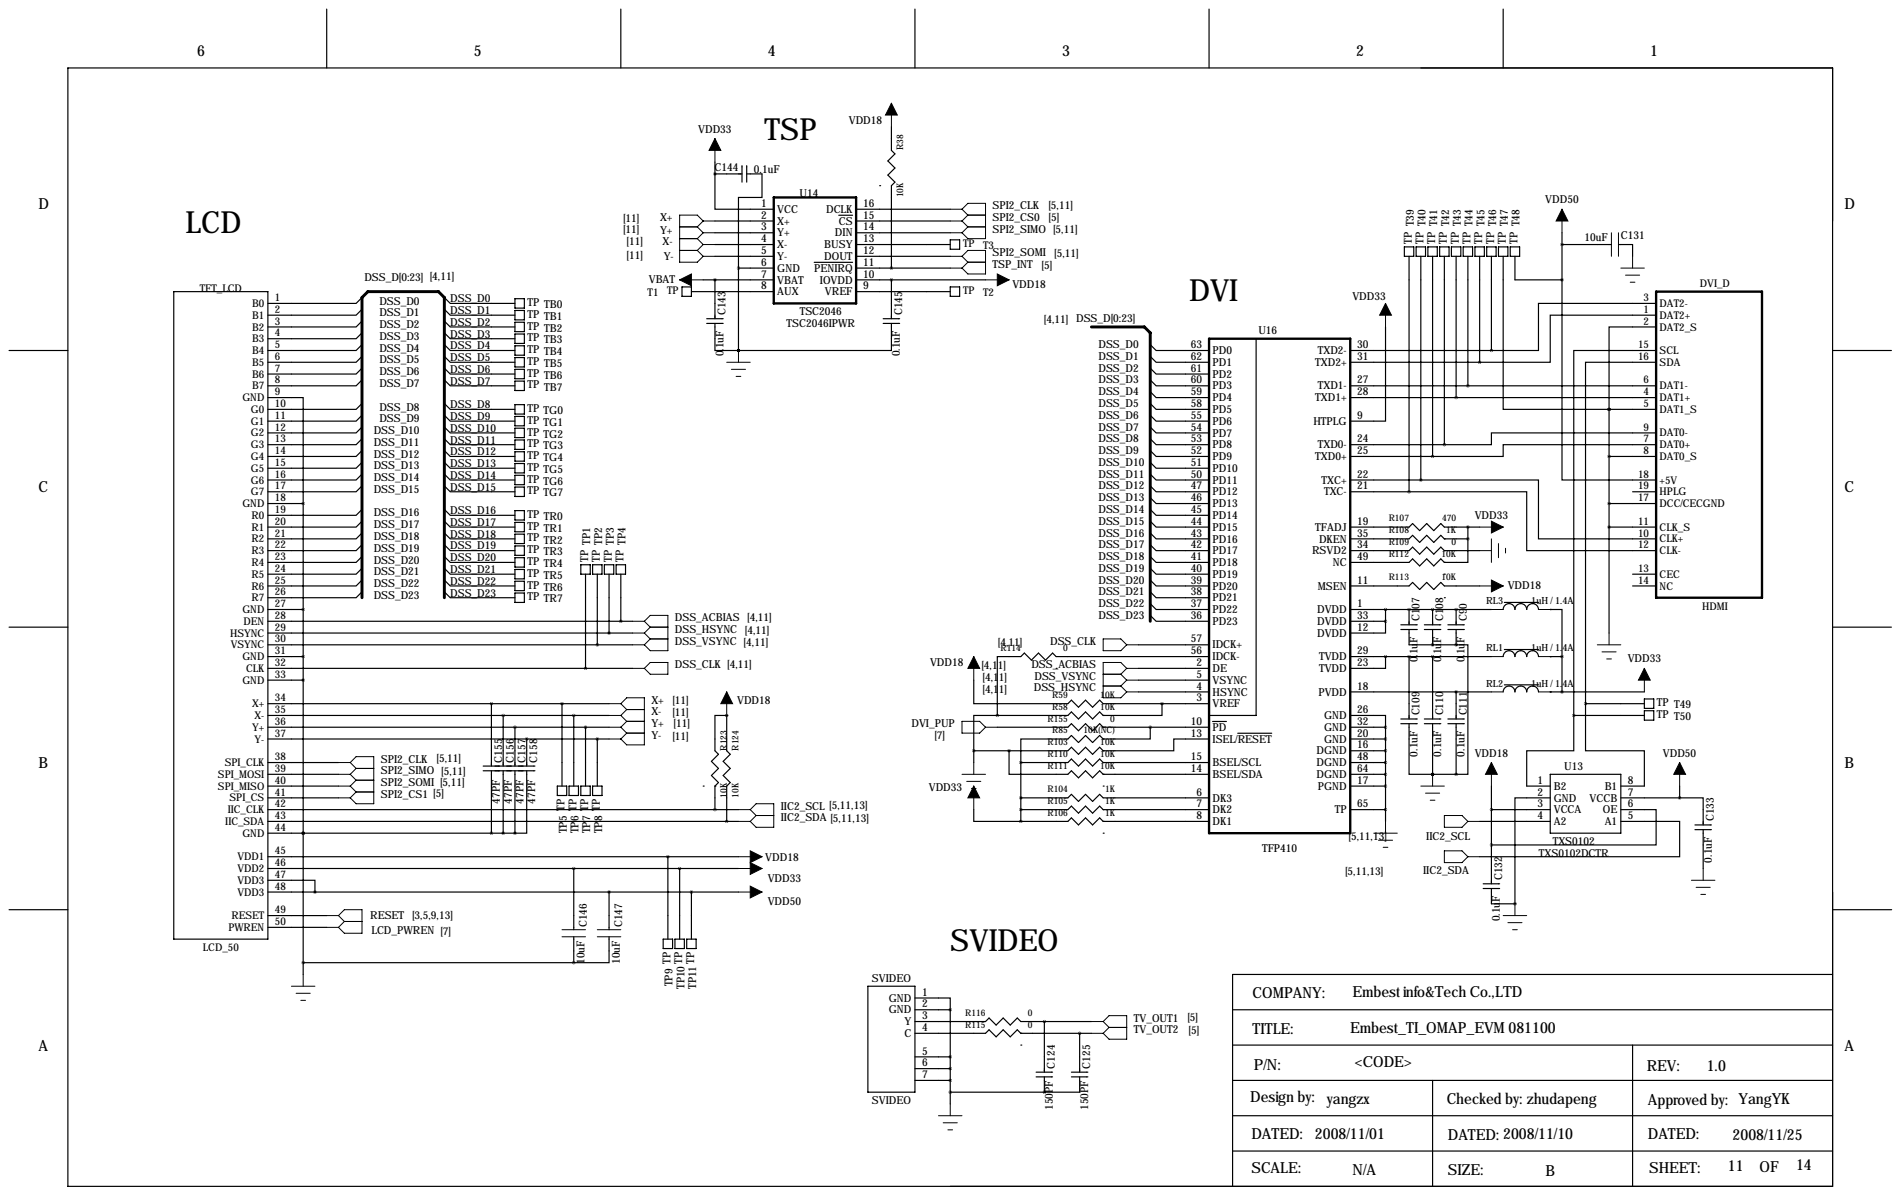
[picture p41: page 9]

Embest info&Tech Co.,LTD

P/N: <CODE> | 1.0 REV:

Design by: yangzx | Checked by: zhudapeng | Approved by: YangYK

DATED: 2008/11/01 | DATED: 2008/11/10 | DATED: 2008/11/25

SHEET: 11 OF 14

D

D

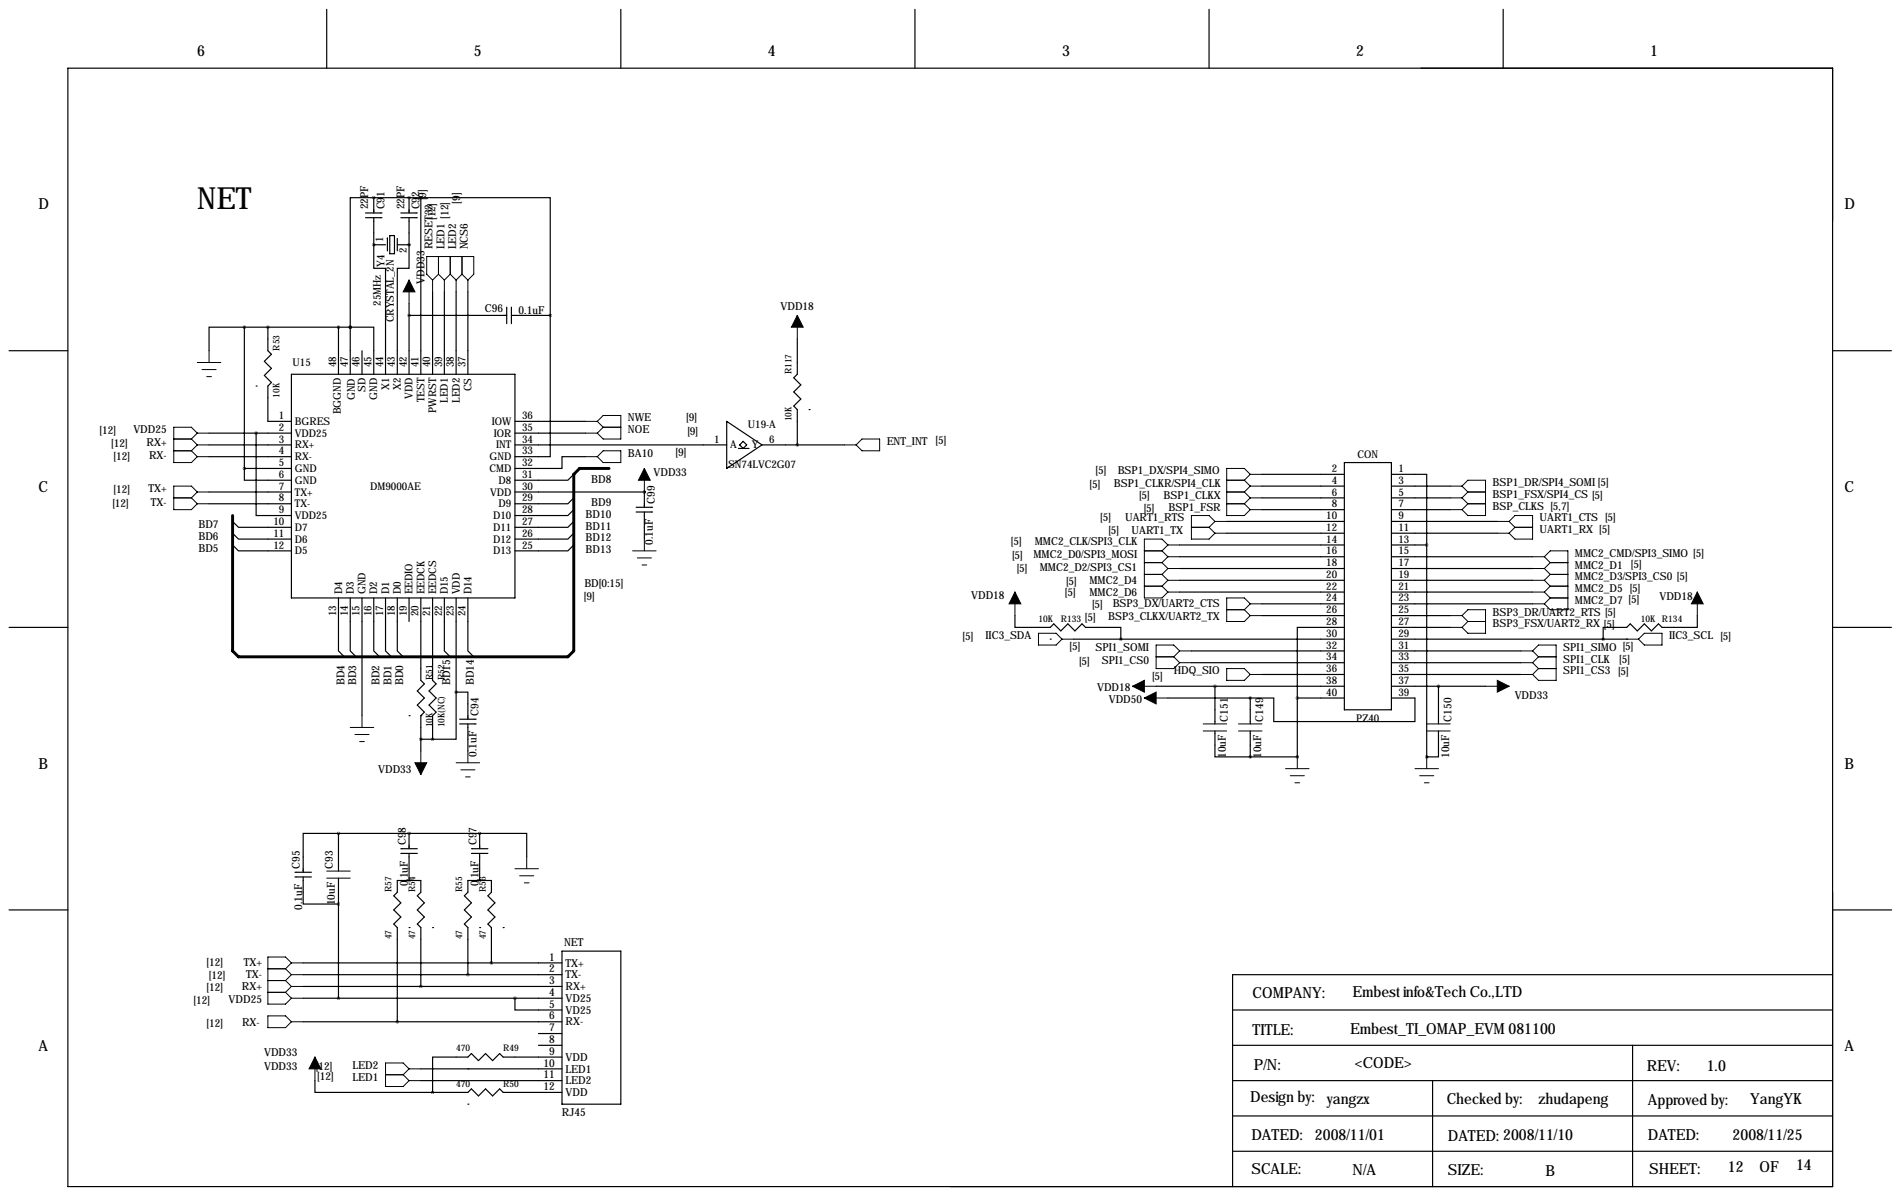
[picture p42: page 10]

13 D4 14 D3 15 GND 16 D2 17 D1 18 D0 19 EEDIO 20 EEDCK 21 EEDCS 22 D15 23 VDD 24 D14

Embest info&Tech Co.,LTD

P/N: <CODE> | REV: 1.0

Design by: yangzx | Checked by: zhudapeng | Approved by: YangYK

DATED: 2008/11/01 | 2008/11/10 DATED: | DATED: 2008/11/25

SHEET: 12 OF 14

D

D

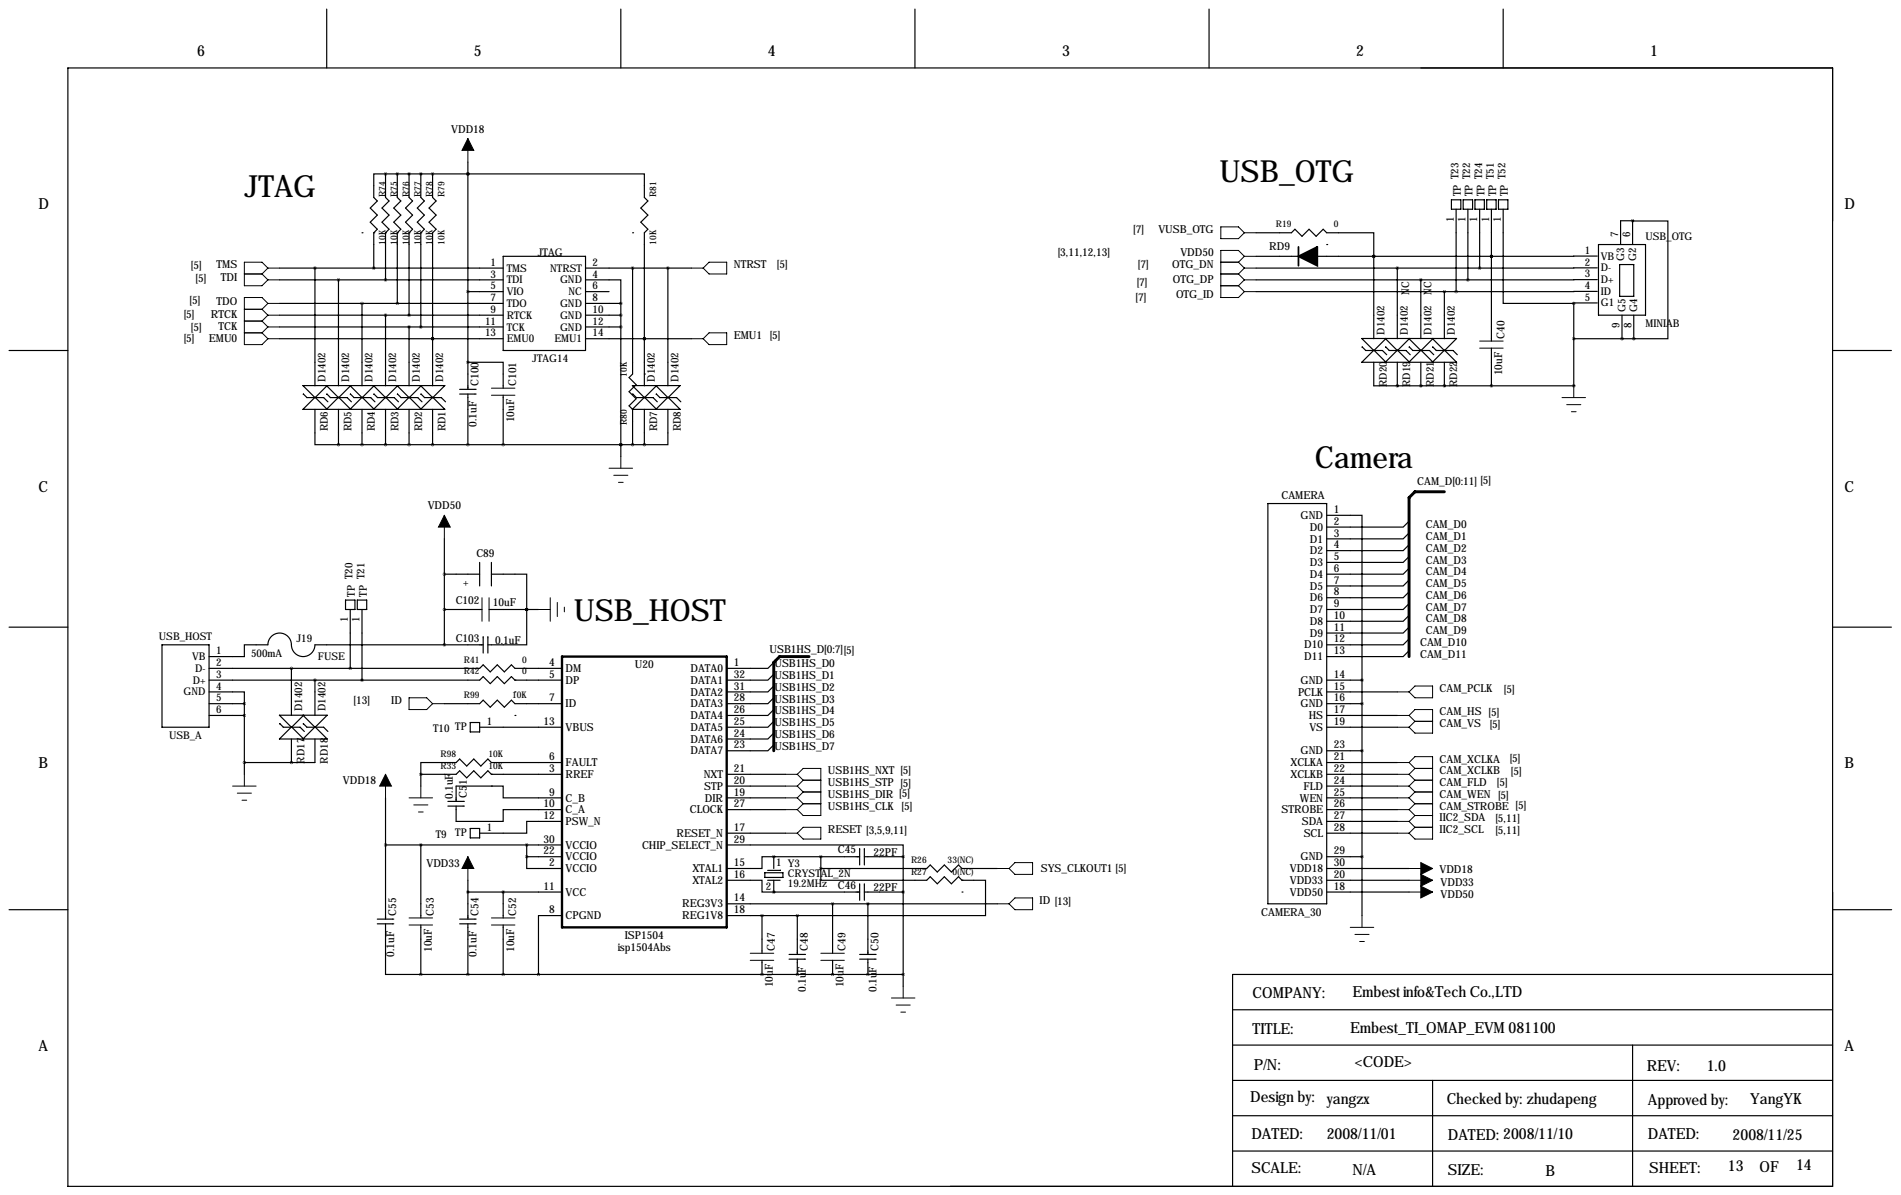
[picture p43: page 11]

Embest info&Tech Co.,LTD

P/N: <CODE> | 1.0 REV:

Design by: yangzx | Checked by: zhudapeng | Approved by: YangYK

DATED: 2008/11/01 | DATED: 2008/11/10 | DATED: 2008/11/25

SHEET: 13 OF 14

6

5

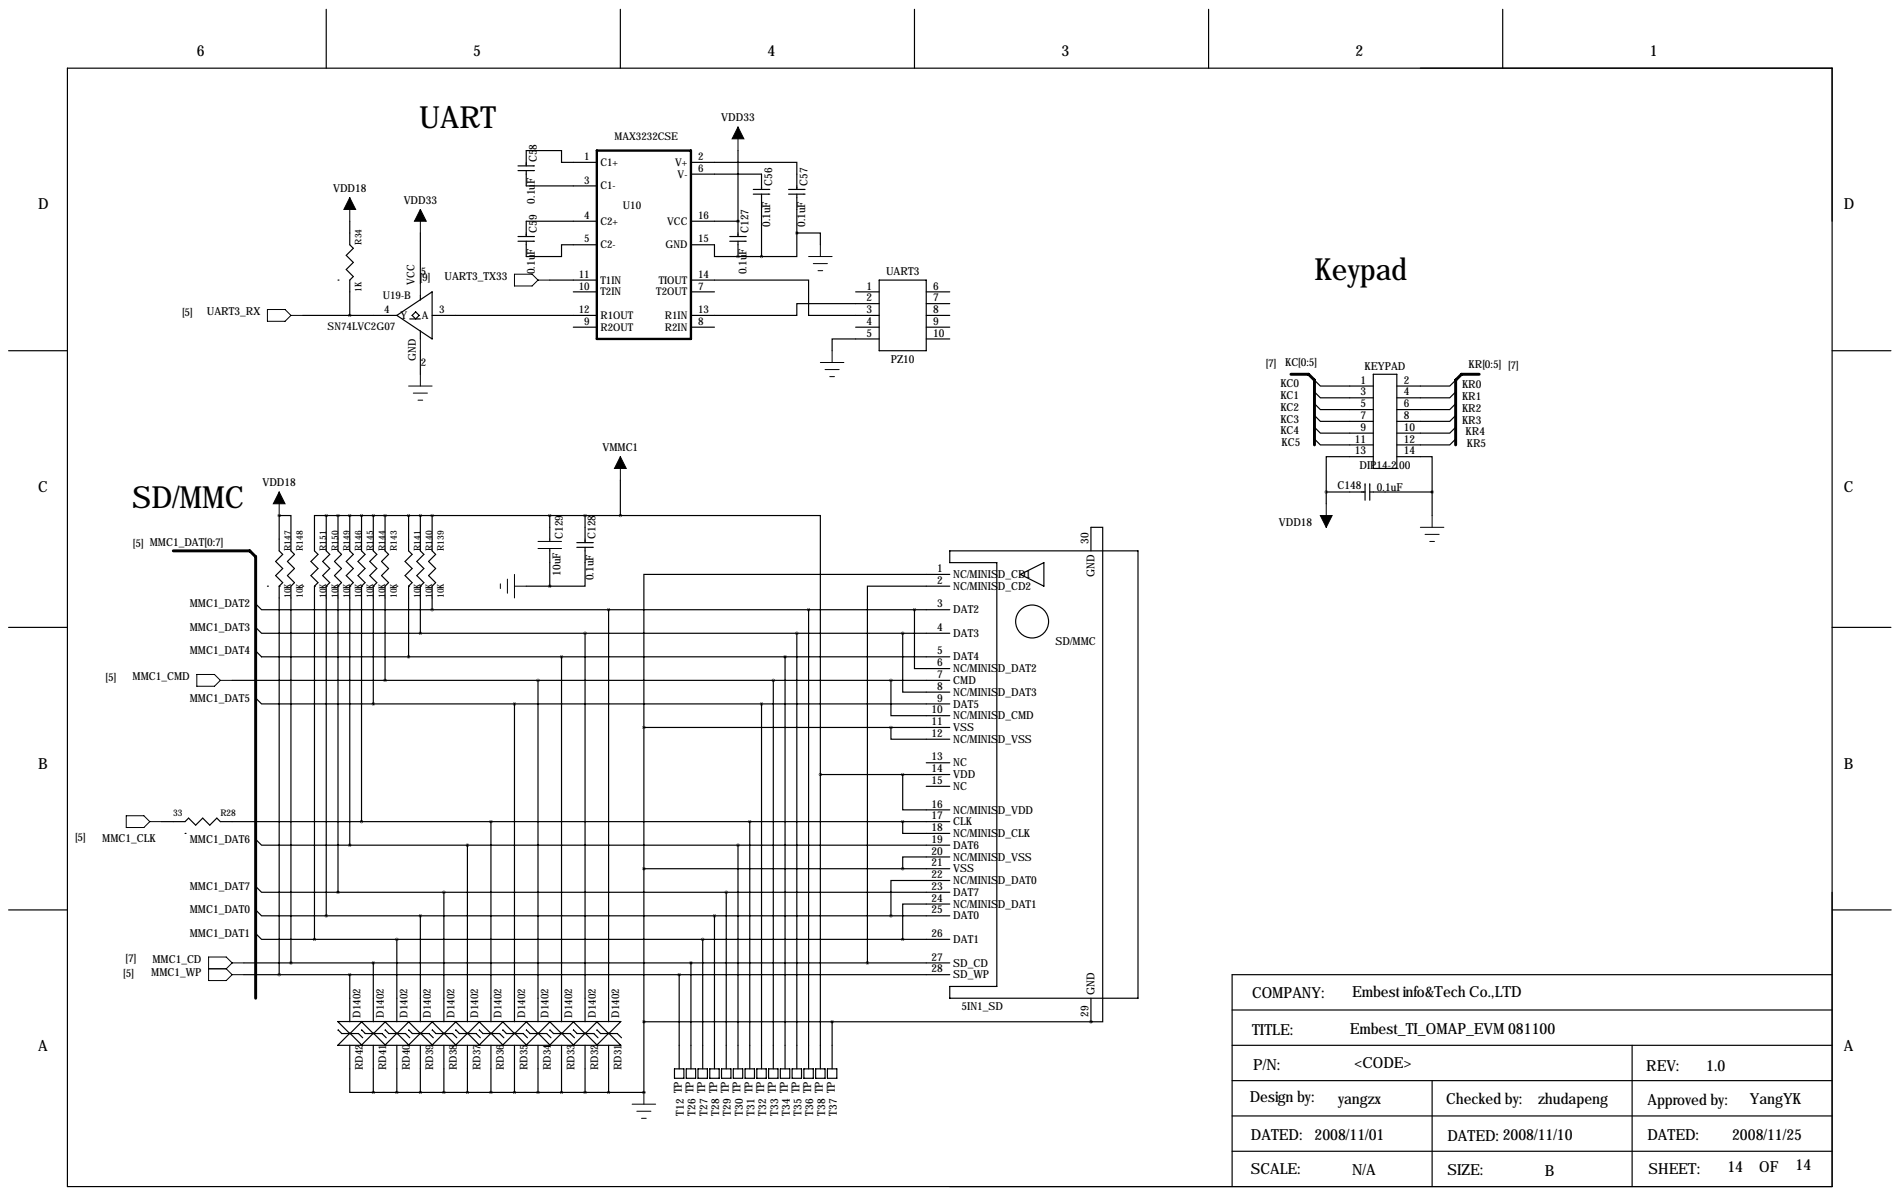
[picture p44: page 12]

16 NC/MINISD_VDD 17 CLK 18 NC/MINISD_CLK 19 DAT6 20 NC/MINISD_VSS 21 VSS 22 NC/MINISD_DAT0 23 DAT7 24 NC/MINISD_DAT1 25 DAT0

Embest info&Tech Co.,LTD

P/N: <CODE> | REV: 1.0

Design by: yangzx | Checked by: zhudapeng | Approved by: YangYK

DATED: 2008/11/01 | 2008/11/10 DATED: | DATED: 2008/11/25

N/A | B | SHEET: 14 OF 14
