dsb92/smartpram/Datablade/Diverse/IC34-0.6 Nm.pdf

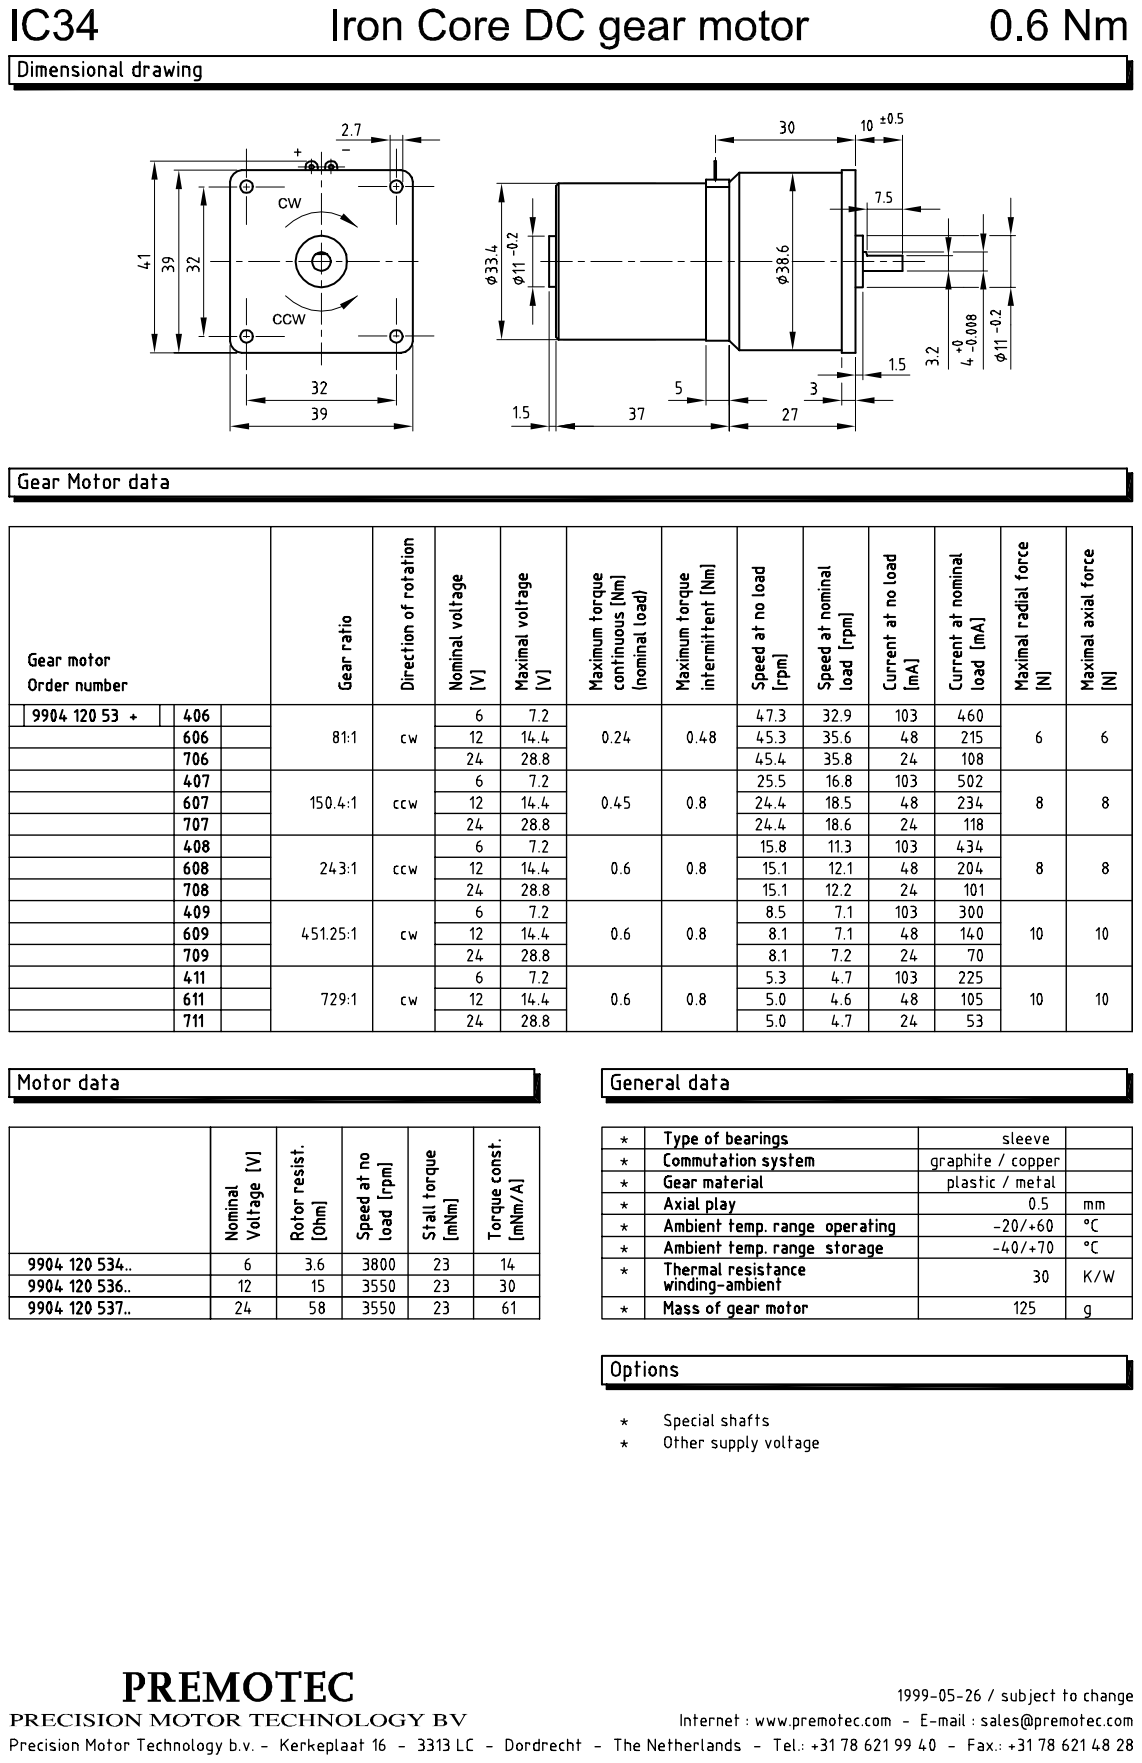
[picture p45: page 1]
