dsb92/smartpram/Software/PSOC3/PSoC_pram_controller.cydsn/codegentemp/Cradle_motor.c

/*******************************************************************************
* File Name: Cradle_motor.c  
* Version 1.90
*
* Description:
*  This file contains API to enable firmware control of a Pins component.
*
* Note:
*
********************************************************************************
* Copyright 2008-2012, Cypress Semiconductor Corporation.  All rights reserved.
* You may use this file only in accordance with the license, terms, conditions, 
* disclaimers, and limitations in the end user license agreement accompanying 
* the software package with which this file was provided.
*******************************************************************************/

#include "cytypes.h"
#include "Cradle_motor.h"


/*******************************************************************************
* Function Name: Cradle_motor_Write
********************************************************************************
*
* Summary:
*  Assign a new value to the digital port's data output register.  
*
* Parameters:  
*  prtValue:  The value to be assigned to the Digital Port. 
*
* Return: 
*  None 
*  
*******************************************************************************/
void Cradle_motor_Write(uint8 value) 
{
    uint8 staticBits = (Cradle_motor_DR & (uint8)(~Cradle_motor_MASK));
    Cradle_motor_DR = staticBits | ((uint8)(value << Cradle_motor_SHIFT) & Cradle_motor_MASK);
}


/*******************************************************************************
* Function Name: Cradle_motor_SetDriveMode
********************************************************************************
*
* Summary:
*  Change the drive mode on the pins of the port.
* 
* Parameters:  
*  mode:  Change the pins to this drive mode.
*
* Return: 
*  None
*
*******************************************************************************/
void Cradle_motor_SetDriveMode(uint8 mode) 
{
	CyPins_SetPinDriveMode(Cradle_motor_0, mode);
}


/*******************************************************************************
* Function Name: Cradle_motor_Read
********************************************************************************
*
* Summary:
*  Read the current value on the pins of the Digital Port in right justified 
*  form.
*
* Parameters:  
*  None 
*
* Return: 
*  Returns the current value of the Digital Port as a right justified number
*  
* Note:
*  Macro Cradle_motor_ReadPS calls this function. 
*  
*******************************************************************************/
uint8 Cradle_motor_Read(void) 
{
    return (Cradle_motor_PS & Cradle_motor_MASK) >> Cradle_motor_SHIFT;
}


/*******************************************************************************
* Function Name: Cradle_motor_ReadDataReg
********************************************************************************
*
* Summary:
*  Read the current value assigned to a Digital Port's data output register
*
* Parameters:  
*  None 
*
* Return: 
*  Returns the current value assigned to the Digital Port's data output register
*  
*******************************************************************************/
uint8 Cradle_motor_ReadDataReg(void) 
{
    return (Cradle_motor_DR & Cradle_motor_MASK) >> Cradle_motor_SHIFT;
}


/* If Interrupts Are Enabled for this Pins component */ 
#if defined(Cradle_motor_INTSTAT) 

    /*******************************************************************************
    * Function Name: Cradle_motor_ClearInterrupt
    ********************************************************************************
    *
    * Summary:
    *  Clears any active interrupts attached to port and returns the value of the 
    *  interrupt status register.
    *
    * Parameters:  
    *  None 
    *
    * Return: 
    *  Returns the value of the interrupt status register
    *  
    *******************************************************************************/
    uint8 Cradle_motor_ClearInterrupt(void) 
    {
        return (Cradle_motor_INTSTAT & Cradle_motor_MASK) >> Cradle_motor_SHIFT;
    }

#endif /* If Interrupts Are Enabled for this Pins component */ 


/* [] END OF FILE */
