dsb92/smartpram/Software/PSOC3/PSoC_pram_controller.cydsn/codegentemp/isr_Receive_Data.c

/*******************************************************************************
* File Name: isr_Receive_Data.c  
* Version 1.70
*
*  Description:
*   API for controlling the state of an interrupt.
*
*
*  Note:
*
********************************************************************************
* Copyright 2008-2012, Cypress Semiconductor Corporation.  All rights reserved.
* You may use this file only in accordance with the license, terms, conditions, 
* disclaimers, and limitations in the end user license agreement accompanying 
* the software package with which this file was provided.
*******************************************************************************/

#include <cydevice_trm.h>
#include <CyLib.h>
#include <isr_Receive_Data.h>

#if !defined(isr_Receive_Data__REMOVED) /* Check for removal by optimization */

/*******************************************************************************
*  Place your includes, defines and code here 
********************************************************************************/
/* `#START isr_Receive_Data_intc` */

/* `#END` */


/*******************************************************************************
* Function Name: isr_Receive_Data_Start
********************************************************************************
*
* Summary:
*  Set up the interrupt and enable it.
*
* Parameters:  
*   None
*
* Return:
*   None
*
*******************************************************************************/
void isr_Receive_Data_Start(void) 
{
    /* For all we know the interrupt is active. */
    isr_Receive_Data_Disable();

    /* Set the ISR to point to the isr_Receive_Data Interrupt. */
    isr_Receive_Data_SetVector(&isr_Receive_Data_Interrupt);

    /* Set the priority. */
    isr_Receive_Data_SetPriority((uint8)isr_Receive_Data_INTC_PRIOR_NUMBER);

    /* Enable it. */
    isr_Receive_Data_Enable();
}


/*******************************************************************************
* Function Name: isr_Receive_Data_StartEx
********************************************************************************
*
* Summary:
*  Set up the interrupt and enable it.
*
* Parameters:  
*   address: Address of the ISR to set in the interrupt vector table.
*
* Return:
*   None
*
*******************************************************************************/
void isr_Receive_Data_StartEx(cyisraddress address) 
{
    /* For all we know the interrupt is active. */
    isr_Receive_Data_Disable();

    /* Set the ISR to point to the isr_Receive_Data Interrupt. */
    isr_Receive_Data_SetVector(address);

    /* Set the priority. */
    isr_Receive_Data_SetPriority((uint8)isr_Receive_Data_INTC_PRIOR_NUMBER);

    /* Enable it. */
    isr_Receive_Data_Enable();
}


/*******************************************************************************
* Function Name: isr_Receive_Data_Stop
********************************************************************************
*
* Summary:
*   Disables and removes the interrupt.
*
* Parameters:  
*   None
*
* Return:
*   None
*
*******************************************************************************/
void isr_Receive_Data_Stop(void) 
{
    /* Disable this interrupt. */
    isr_Receive_Data_Disable();
}


/*******************************************************************************
* Function Name: isr_Receive_Data_Interrupt
********************************************************************************
* Summary:
*   The default Interrupt Service Routine for isr_Receive_Data.
*
*   Add custom code between the coments to keep the next version of this file
*   from over writting your code.
*
* Parameters:  
*   None
*
* Return:
*   None
*
*******************************************************************************/
CY_ISR(isr_Receive_Data_Interrupt)
{
    /*  Place your Interrupt code here. */
    /* `#START isr_Receive_Data_Interrupt` */

    /* `#END` */

    /* PSoC3 ES1, ES2 RTC ISR PATCH  */ 
    #if(CYDEV_CHIP_FAMILY_USED == CYDEV_CHIP_FAMILY_PSOC3)
        #if((CYDEV_CHIP_REVISION_USED <= CYDEV_CHIP_REVISION_3A_ES2) && (isr_Receive_Data__ES2_PATCH ))      
            isr_Receive_Data_ISR_PATCH();
        #endif /* CYDEV_CHIP_REVISION_USED */
    #endif /* (CYDEV_CHIP_FAMILY_USED == CYDEV_CHIP_FAMILY_PSOC3) */
}


/*******************************************************************************
* Function Name: isr_Receive_Data_SetVector
********************************************************************************
*
* Summary:
*   Change the ISR vector for the Interrupt. Note calling isr_Receive_Data_Start
*   will override any effect this method would have had. To set the vector 
*   before the component has been started use isr_Receive_Data_StartEx instead.
*
* Parameters:
*   address: Address of the ISR to set in the interrupt vector table.
*
* Return:
*   None
*
*******************************************************************************/
void isr_Receive_Data_SetVector(cyisraddress address) 
{
    CY_SET_REG16(isr_Receive_Data_INTC_VECTOR, (uint16) address);
}


/*******************************************************************************
* Function Name: isr_Receive_Data_GetVector
********************************************************************************
*
* Summary:
*   Gets the "address" of the current ISR vector for the Interrupt.
*
* Parameters:
*   None
*
* Return:
*   Address of the ISR in the interrupt vector table.
*
*******************************************************************************/
cyisraddress isr_Receive_Data_GetVector(void) 
{
    return (cyisraddress) CY_GET_REG16(isr_Receive_Data_INTC_VECTOR);
}


/*******************************************************************************
* Function Name: isr_Receive_Data_SetPriority
********************************************************************************
*
* Summary:
*   Sets the Priority of the Interrupt. Note calling isr_Receive_Data_Start
*   or isr_Receive_Data_StartEx will override any effect this method would 
*   have had. This method should only be called after isr_Receive_Data_Start or 
*   isr_Receive_Data_StartEx has been called. To set the initial
*   priority for the component use the cydwr file in the tool.
*
* Parameters:
*   priority: Priority of the interrupt. 0 - 7, 0 being the highest.
*
* Return:
*   None
*
*******************************************************************************/
void isr_Receive_Data_SetPriority(uint8 priority) 
{
    *isr_Receive_Data_INTC_PRIOR = priority << 5;
}


/*******************************************************************************
* Function Name: isr_Receive_Data_GetPriority
********************************************************************************
*
* Summary:
*   Gets the Priority of the Interrupt.
*
* Parameters:
*   None
*
* Return:
*   Priority of the interrupt. 0 - 7, 0 being the highest.
*
*******************************************************************************/
uint8 isr_Receive_Data_GetPriority(void) 
{
    uint8 priority;


    priority = *isr_Receive_Data_INTC_PRIOR >> 5;

    return priority;
}


/*******************************************************************************
* Function Name: isr_Receive_Data_Enable
********************************************************************************
*
* Summary:
*   Enables the interrupt.
*
* Parameters:
*   None
*
* Return:
*   None
*
*******************************************************************************/
void isr_Receive_Data_Enable(void) 
{
    /* Enable the general interrupt. */
    *isr_Receive_Data_INTC_SET_EN = isr_Receive_Data__INTC_MASK;
}


/*******************************************************************************
* Function Name: isr_Receive_Data_GetState
********************************************************************************
*
* Summary:
*   Gets the state (enabled, disabled) of the Interrupt.
*
* Parameters:
*   None
*
* Return:
*   1 if enabled, 0 if disabled.
*
*******************************************************************************/
uint8 isr_Receive_Data_GetState(void) 
{
    /* Get the state of the general interrupt. */
    return ((*isr_Receive_Data_INTC_SET_EN & (uint8)isr_Receive_Data__INTC_MASK) != 0u) ? 1u:0u;
}


/*******************************************************************************
* Function Name: isr_Receive_Data_Disable
********************************************************************************
*
* Summary:
*   Disables the Interrupt.
*
* Parameters:
*   None
*
* Return:
*   None
*
*******************************************************************************/
void isr_Receive_Data_Disable(void) 
{
    /* Disable the general interrupt. */
    *isr_Receive_Data_INTC_CLR_EN = isr_Receive_Data__INTC_MASK;
}


/*******************************************************************************
* Function Name: isr_Receive_Data_SetPending
********************************************************************************
*
* Summary:
*   Causes the Interrupt to enter the pending state, a software method of
*   generating the interrupt.
*
* Parameters:
*   None
*
* Return:
*   None
*
*******************************************************************************/
void isr_Receive_Data_SetPending(void) 
{
    *isr_Receive_Data_INTC_SET_PD = isr_Receive_Data__INTC_MASK;
}


/*******************************************************************************
* Function Name: isr_Receive_Data_ClearPending
********************************************************************************
*
* Summary:
*   Clears a pending interrupt.
*
* Parameters:
*   None
*
* Return:
*   None
*
*******************************************************************************/
void isr_Receive_Data_ClearPending(void) 
{
    *isr_Receive_Data_INTC_CLR_PD = isr_Receive_Data__INTC_MASK;
}

#endif /* End check for removal by optimization */


/* [] END OF FILE */
