dsb92/smartpram/Software/PSOC3/PSoC_pram_controller.cydsn/codegentemp/Filter_1.h

/*******************************************************************************
* File Name: Filter_1.h
* Version 2.20
*
* Description:
*  This header file contains definitions associated with the FILT component.
*
* Note:
* 
********************************************************************************
* Copyright 2008-2013, Cypress Semiconductor Corporation.  All rights reserved.
* You may use this file only in accordance with the license, terms, conditions, 
* disclaimers, and limitations in the end user license agreement accompanying 
* the software package with which this file was provided.
*******************************************************************************/

#if !defined(Filter_1_H) /* FILT Header File */
#define Filter_1_H

#include "cyfitter.h"
#include "CyLib.h"

extern uint8 Filter_1_initVar;


/***************************************
*   Conditional Compilation Parameters
***************************************/
#define Filter_1_DA_RAM_SIZE_CUR        (0x200u)
#define Filter_1_DB_RAM_SIZE_CUR        (0x200u)
#define Filter_1_CSA_RAM_SIZE_CUR       (0x100u)
#define Filter_1_CSB_RAM_SIZE_CUR       (0x100u)
#define Filter_1_CFSM_RAM_SIZE_CUR      (0x100u)
#define Filter_1_ACU_RAM_SIZE_CUR       (0x40u)

#define Filter_1_FIR_A_SIZE       (100u)
	
extern const uint8 CYCODE Filter_1_ChannelAFirCoefficients[Filter_1_FIR_A_SIZE];


/***************************************
*     Data Struct Definition
***************************************/

/* Low power Mode API Support */
typedef struct 
{
    uint8 enableState;
    uint8 cr;
    uint8 sr;
    uint8 sema;
    uint8 saveAcu[Filter_1_ACU_RAM_SIZE_CUR];
}   Filter_1_backupStruct;


/***************************************
* FILT component function prototypes.
****************************************/

void   Filter_1_Start(void) ;
void   Filter_1_Stop(void) ;
uint8 Filter_1_Read8(uint8 channel) ;
uint16 Filter_1_Read16(uint8 channel) ;
uint32 Filter_1_Read24(uint8 channel) ;
void Filter_1_Write8(uint8 channel, uint8 sample) ;
void Filter_1_Write16(uint8 channel, uint16 sample) ;
void Filter_1_Write24(uint8 channel, uint32 sample) ;
void Filter_1_Sleep(void) ;
void Filter_1_Wakeup(void) ;
void Filter_1_SaveConfig(void) ;
void Filter_1_RestoreConfig(void) ;
void Filter_1_Init(void) ;
void Filter_1_Enable(void) ;
void Filter_1_SetCoherency(uint8 channel, uint8 byteSelect) ;


/*****************************************
* FILT component API Constants.
******************************************/

/* Channel Definitions */
#define Filter_1_CHANNEL_A             (0u)
#define Filter_1_CHANNEL_B             (1u)

#define Filter_1_CHANNEL_A_INTR        (0x08u)
#define Filter_1_CHANNEL_B_INTR        (0x10u)

#define Filter_1_ALL_INTR              (0xf8u)

#define Filter_1_SIGN_BIT              ((uint32)0x00800000u)
#define Filter_1_SIGN_BYTE             ((uint32)0xFF000000u)

/* Component's enable/disable state */
#define Filter_1_ENABLED               (0x01u)
#define Filter_1_DISABLED              (0x00u)

/* SetCoherency API constants */
#define Filter_1_KEY_LOW               (0x00u)
#define Filter_1_KEY_MID               (0x01u)
#define Filter_1_KEY_HIGH              (0x02u)


/*******************************************************************************
* FILT component macros.
*******************************************************************************/

#define Filter_1_ClearInterruptSource() \
   (Filter_1_SR_REG = Filter_1_ALL_INTR )

#define Filter_1_IsInterruptChannelA() \
    (Filter_1_SR_REG & Filter_1_CHANNEL_A_INTR)

#define Filter_1_IsInterruptChannelB() \
    (Filter_1_SR_REG & Filter_1_CHANNEL_B_INTR)


/*******************************************************************************
* FILT component DFB registers.
*******************************************************************************/

/* DFB Status register */
#define Filter_1_SR_REG             (* (reg8 *) Filter_1_DFB__SR)
#define Filter_1_SR_PTR             (  (reg8 *) Filter_1_DFB__SR)

/* DFB Control register */
#define Filter_1_CR_REG             (* (reg8 *) Filter_1_DFB__CR)
#define Filter_1_CR_PTR             (  (reg8 *) Filter_1_DFB__CR)


/*******************************************************************************
* DFB.COHER bit field defines.
*******************************************************************************/

/* STAGEA key coherency mask */
#define Filter_1_STAGEA_COHER_MASK    (0x03u)

/* HOLDA key coherency mask */
#define Filter_1_HOLDA_COHER_MASK     ((uint8)((uint8)0x03u << 4u))

/* STAGEB key coherency mask */
#define Filter_1_STAGEB_COHER_MASK    (0x0Cu)

/* HOLDB key coherency mask */
#define Filter_1_HOLDB_COHER_MASK     ((uint8)((uint8)0x0Cu << 4u))


#endif /* End FILT Header File */


/* [] END OF FILE */
