dsb92/smartpram/Software/PSOC3/PSoC_pram_controller.cydsn/codegentemp/Signal_in.h

/*******************************************************************************
* File Name: Signal_in.h  
* Version 1.90
*
* Description:
*  This file containts Control Register function prototypes and register defines
*
* Note:
*
********************************************************************************
* Copyright 2008-2012, Cypress Semiconductor Corporation.  All rights reserved.
* You may use this file only in accordance with the license, terms, conditions, 
* disclaimers, and limitations in the end user license agreement accompanying 
* the software package with which this file was provided.
*******************************************************************************/

#if !defined(CY_PINS_Signal_in_H) /* Pins Signal_in_H */
#define CY_PINS_Signal_in_H

#include "cytypes.h"
#include "cyfitter.h"
#include "cypins.h"
#include "Signal_in_aliases.h"


/***************************************
*        Function Prototypes             
***************************************/    

void    Signal_in_Write(uint8 value) ;
void    Signal_in_SetDriveMode(uint8 mode) ;
uint8   Signal_in_ReadDataReg(void) ;
uint8   Signal_in_Read(void) ;
uint8   Signal_in_ClearInterrupt(void) ;


/***************************************
*           API Constants        
***************************************/

/* Drive Modes */
#define Signal_in_DM_ALG_HIZ         PIN_DM_ALG_HIZ
#define Signal_in_DM_DIG_HIZ         PIN_DM_DIG_HIZ
#define Signal_in_DM_RES_UP          PIN_DM_RES_UP
#define Signal_in_DM_RES_DWN         PIN_DM_RES_DWN
#define Signal_in_DM_OD_LO           PIN_DM_OD_LO
#define Signal_in_DM_OD_HI           PIN_DM_OD_HI
#define Signal_in_DM_STRONG          PIN_DM_STRONG
#define Signal_in_DM_RES_UPDWN       PIN_DM_RES_UPDWN

/* Digital Port Constants */
#define Signal_in_MASK               Signal_in__MASK
#define Signal_in_SHIFT              Signal_in__SHIFT
#define Signal_in_WIDTH              1u


/***************************************
*             Registers        
***************************************/

/* Main Port Registers */
/* Pin State */
#define Signal_in_PS                     (* (reg8 *) Signal_in__PS)
/* Data Register */
#define Signal_in_DR                     (* (reg8 *) Signal_in__DR)
/* Port Number */
#define Signal_in_PRT_NUM                (* (reg8 *) Signal_in__PRT) 
/* Connect to Analog Globals */                                                  
#define Signal_in_AG                     (* (reg8 *) Signal_in__AG)                       
/* Analog MUX bux enable */
#define Signal_in_AMUX                   (* (reg8 *) Signal_in__AMUX) 
/* Bidirectional Enable */                                                        
#define Signal_in_BIE                    (* (reg8 *) Signal_in__BIE)
/* Bit-mask for Aliased Register Access */
#define Signal_in_BIT_MASK               (* (reg8 *) Signal_in__BIT_MASK)
/* Bypass Enable */
#define Signal_in_BYP                    (* (reg8 *) Signal_in__BYP)
/* Port wide control signals */                                                   
#define Signal_in_CTL                    (* (reg8 *) Signal_in__CTL)
/* Drive Modes */
#define Signal_in_DM0                    (* (reg8 *) Signal_in__DM0) 
#define Signal_in_DM1                    (* (reg8 *) Signal_in__DM1)
#define Signal_in_DM2                    (* (reg8 *) Signal_in__DM2) 
/* Input Buffer Disable Override */
#define Signal_in_INP_DIS                (* (reg8 *) Signal_in__INP_DIS)
/* LCD Common or Segment Drive */
#define Signal_in_LCD_COM_SEG            (* (reg8 *) Signal_in__LCD_COM_SEG)
/* Enable Segment LCD */
#define Signal_in_LCD_EN                 (* (reg8 *) Signal_in__LCD_EN)
/* Slew Rate Control */
#define Signal_in_SLW                    (* (reg8 *) Signal_in__SLW)

/* DSI Port Registers */
/* Global DSI Select Register */
#define Signal_in_PRTDSI__CAPS_SEL       (* (reg8 *) Signal_in__PRTDSI__CAPS_SEL) 
/* Double Sync Enable */
#define Signal_in_PRTDSI__DBL_SYNC_IN    (* (reg8 *) Signal_in__PRTDSI__DBL_SYNC_IN) 
/* Output Enable Select Drive Strength */
#define Signal_in_PRTDSI__OE_SEL0        (* (reg8 *) Signal_in__PRTDSI__OE_SEL0) 
#define Signal_in_PRTDSI__OE_SEL1        (* (reg8 *) Signal_in__PRTDSI__OE_SEL1) 
/* Port Pin Output Select Registers */
#define Signal_in_PRTDSI__OUT_SEL0       (* (reg8 *) Signal_in__PRTDSI__OUT_SEL0) 
#define Signal_in_PRTDSI__OUT_SEL1       (* (reg8 *) Signal_in__PRTDSI__OUT_SEL1) 
/* Sync Output Enable Registers */
#define Signal_in_PRTDSI__SYNC_OUT       (* (reg8 *) Signal_in__PRTDSI__SYNC_OUT) 


#if defined(Signal_in__INTSTAT)  /* Interrupt Registers */

    #define Signal_in_INTSTAT                (* (reg8 *) Signal_in__INTSTAT)
    #define Signal_in_SNAP                   (* (reg8 *) Signal_in__SNAP)

#endif /* Interrupt Registers */

#endif /* End Pins Signal_in_H */


/* [] END OF FILE */
