dsb92/smartpram/Software/PSOC3/PSoC_pram_controller.cydsn/codegentemp/nRESET.h

/*******************************************************************************
* File Name: nRESET.h  
* Version 1.90
*
* Description:
*  This file containts Control Register function prototypes and register defines
*
* Note:
*
********************************************************************************
* Copyright 2008-2012, Cypress Semiconductor Corporation.  All rights reserved.
* You may use this file only in accordance with the license, terms, conditions, 
* disclaimers, and limitations in the end user license agreement accompanying 
* the software package with which this file was provided.
*******************************************************************************/

#if !defined(CY_PINS_nRESET_H) /* Pins nRESET_H */
#define CY_PINS_nRESET_H

#include "cytypes.h"
#include "cyfitter.h"
#include "cypins.h"
#include "nRESET_aliases.h"


/***************************************
*        Function Prototypes             
***************************************/    

void    nRESET_Write(uint8 value) ;
void    nRESET_SetDriveMode(uint8 mode) ;
uint8   nRESET_ReadDataReg(void) ;
uint8   nRESET_Read(void) ;
uint8   nRESET_ClearInterrupt(void) ;


/***************************************
*           API Constants        
***************************************/

/* Drive Modes */
#define nRESET_DM_ALG_HIZ         PIN_DM_ALG_HIZ
#define nRESET_DM_DIG_HIZ         PIN_DM_DIG_HIZ
#define nRESET_DM_RES_UP          PIN_DM_RES_UP
#define nRESET_DM_RES_DWN         PIN_DM_RES_DWN
#define nRESET_DM_OD_LO           PIN_DM_OD_LO
#define nRESET_DM_OD_HI           PIN_DM_OD_HI
#define nRESET_DM_STRONG          PIN_DM_STRONG
#define nRESET_DM_RES_UPDWN       PIN_DM_RES_UPDWN

/* Digital Port Constants */
#define nRESET_MASK               nRESET__MASK
#define nRESET_SHIFT              nRESET__SHIFT
#define nRESET_WIDTH              1u


/***************************************
*             Registers        
***************************************/

/* Main Port Registers */
/* Pin State */
#define nRESET_PS                     (* (reg8 *) nRESET__PS)
/* Data Register */
#define nRESET_DR                     (* (reg8 *) nRESET__DR)
/* Port Number */
#define nRESET_PRT_NUM                (* (reg8 *) nRESET__PRT) 
/* Connect to Analog Globals */                                                  
#define nRESET_AG                     (* (reg8 *) nRESET__AG)                       
/* Analog MUX bux enable */
#define nRESET_AMUX                   (* (reg8 *) nRESET__AMUX) 
/* Bidirectional Enable */                                                        
#define nRESET_BIE                    (* (reg8 *) nRESET__BIE)
/* Bit-mask for Aliased Register Access */
#define nRESET_BIT_MASK               (* (reg8 *) nRESET__BIT_MASK)
/* Bypass Enable */
#define nRESET_BYP                    (* (reg8 *) nRESET__BYP)
/* Port wide control signals */                                                   
#define nRESET_CTL                    (* (reg8 *) nRESET__CTL)
/* Drive Modes */
#define nRESET_DM0                    (* (reg8 *) nRESET__DM0) 
#define nRESET_DM1                    (* (reg8 *) nRESET__DM1)
#define nRESET_DM2                    (* (reg8 *) nRESET__DM2) 
/* Input Buffer Disable Override */
#define nRESET_INP_DIS                (* (reg8 *) nRESET__INP_DIS)
/* LCD Common or Segment Drive */
#define nRESET_LCD_COM_SEG            (* (reg8 *) nRESET__LCD_COM_SEG)
/* Enable Segment LCD */
#define nRESET_LCD_EN                 (* (reg8 *) nRESET__LCD_EN)
/* Slew Rate Control */
#define nRESET_SLW                    (* (reg8 *) nRESET__SLW)

/* DSI Port Registers */
/* Global DSI Select Register */
#define nRESET_PRTDSI__CAPS_SEL       (* (reg8 *) nRESET__PRTDSI__CAPS_SEL) 
/* Double Sync Enable */
#define nRESET_PRTDSI__DBL_SYNC_IN    (* (reg8 *) nRESET__PRTDSI__DBL_SYNC_IN) 
/* Output Enable Select Drive Strength */
#define nRESET_PRTDSI__OE_SEL0        (* (reg8 *) nRESET__PRTDSI__OE_SEL0) 
#define nRESET_PRTDSI__OE_SEL1        (* (reg8 *) nRESET__PRTDSI__OE_SEL1) 
/* Port Pin Output Select Registers */
#define nRESET_PRTDSI__OUT_SEL0       (* (reg8 *) nRESET__PRTDSI__OUT_SEL0) 
#define nRESET_PRTDSI__OUT_SEL1       (* (reg8 *) nRESET__PRTDSI__OUT_SEL1) 
/* Sync Output Enable Registers */
#define nRESET_PRTDSI__SYNC_OUT       (* (reg8 *) nRESET__PRTDSI__SYNC_OUT) 


#if defined(nRESET__INTSTAT)  /* Interrupt Registers */

    #define nRESET_INTSTAT                (* (reg8 *) nRESET__INTSTAT)
    #define nRESET_SNAP                   (* (reg8 *) nRESET__SNAP)

#endif /* Interrupt Registers */

#endif /* End Pins nRESET_H */


/* [] END OF FILE */
